hjunhuh/balancebot-course/part06_mech/README.md

# Part 6. 밸런싱로봇 기구 설계 with Fusion360

이 파트에서는 밸런싱 로봇의 몸체를 직접 설계합니다. 플레이트 3장(하판, 중판, 상판)과 모터 브래킷 1종을 Autodesk Fusion(옛 이름 Fusion 360)으로 모델링하고, 도면을 만들고, 조립해서 간섭을 확인한 뒤 STL로 내보내 3D 프린터로 출력합니다.

같은 부품을 Python 스크립트로도 만들 수 있게 준비했습니다. Fusion에서 만든 모델과 스크립트가 만든 STL을 비교하면 내 치수가 맞는지 바로 확인할 수 있고, 치수를 바꿔야 할 때 스크립트로 빠르게 다시 만들 수 있습니다.

이 파트에서 쓰는 기준 치수는 공통 사양서(SPEC.md) 5장을 그대로 따릅니다.

| 항목 | 값 |
|---|---|
| 플레이트 | 120 x 75 x 4 mm, 3장, 모서리 R4 |
| 모서리 홀 | M4 관통 Ø4.4, 가장자리에서 6 mm 안쪽 (홀 간격 108 x 63) |
| 층간 서포트 | M4 x 50 mm |
| 일반 M3 홀 | Ø3.4 |
| 모터 | 25 mm 기어드 DC 모터, 축 4 mm, 2개 |
| 바퀴 | 지름 130 mm |
| L298N 장착 홀 | 37 x 37 mm, M3 |
| Uno 장착 홀 (보드 기준) | (13.97, 2.54), (15.24, 50.80), (66.04, 7.62), (66.04, 35.56) |

결과물 폴더 구성은 다음과 같습니다.

| 경로 | 내용 |
|---|---|
| `part06_mech/cad/generate.py` | 파라메트릭 생성 스크립트 |
| `part06_mech/stl/` | plate_bottom, plate_middle, plate_top, motor_bracket STL |
| `part06_mech/dxf/` | 레이저 커팅용 플레이트 외곽선 DXF |
| `part06_mech/img/` | 2D 치수 도면과 조립 미리보기 그림 |

## 6-01 기구 설계가 제어에 미치는 영향

밸런싱 로봇은 바퀴 축을 받침점으로 하는 역진자(거꾸로 선 진자)입니다. 펌웨어(Part 8)에서 PID 게인을 아무리 잘 맞춰도 기구가 제어하기 어려운 모양이면 서 있지 못합니다. 설계를 시작하기 전에 네 가지 요소가 제어에 어떤 영향을 주는지 정리합니다.

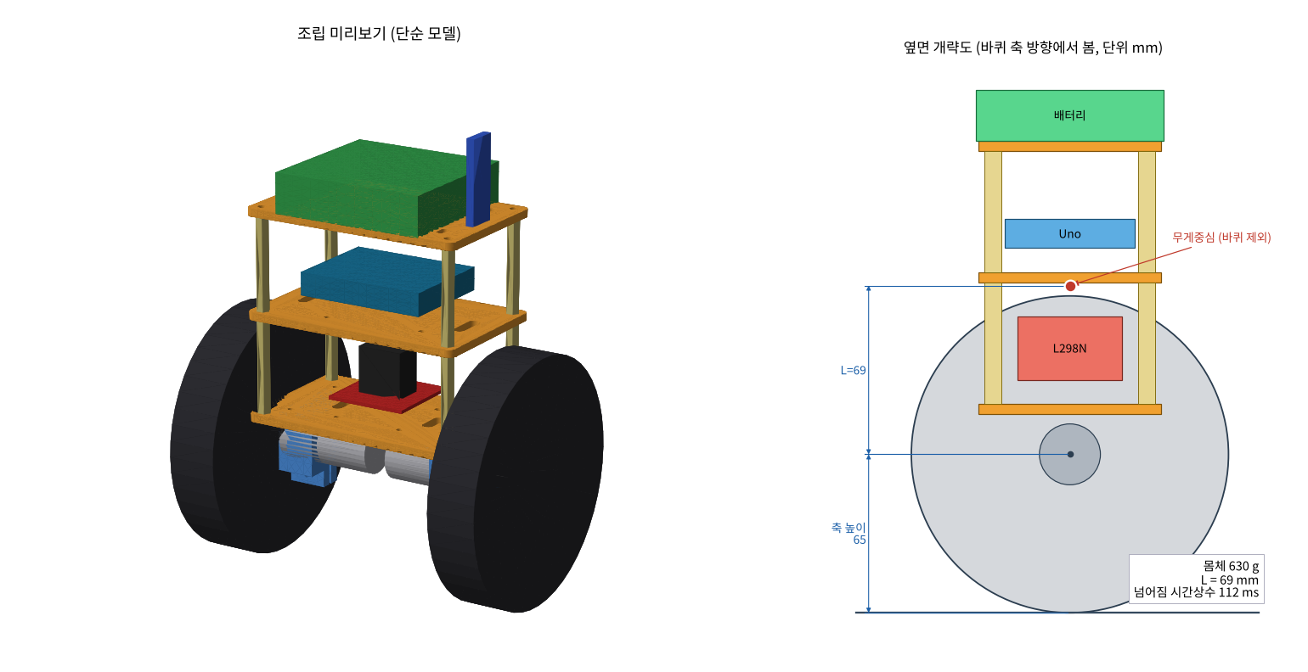
[picture p1: part06_mech/img/assembly_preview.png]
조립 미리보기와 무게중심


### 무게중심 높이 L

축에서 무게중심까지 거리를 L이라고 하면, 기울기 θ가 작을 때 몸체의 운동 방정식은 다음과 같습니다.

```
I * θ'' = m * g * L * θ      (I: 축 기준 관성 모멘트, m: 몸체 질량)
θ(t) = θ0 * e^(t / τ),       τ = sqrt( I / (m * g * L) )
```

τ(타우)는 넘어지는 속도를 나타내는 시간 상수입니다. 기울기가 τ마다 약 2.7배씩 커집니다. 질량이 한 점에 모여 있다고 보면 I = m L² 이므로 τ = sqrt(L / g) 가 되어, **무게중심이 높을수록 τ가 커지고 천천히 넘어집니다**. 빗자루를 손바닥에 세울 때 긴 빗자루가 더 쉬운 것과 같은 원리입니다.

생성 스크립트는 부품 질량 추정값으로 이 값을 직접 계산합니다.

| 배치 | 몸체 질량 | L | τ | 1도에서 20도까지 넘어지는 시간 (약 3τ) |
|---|---|---|---|---|
| 배터리를 상판에 둠 (이 과정의 설계) | 630 g | 69.3 mm | 112 ms | 약 336 ms |
| 배터리를 하판에 둔다고 가정 | 630 g | 32.7 mm | 85 ms | 약 255 ms |

제어 주기가 5 ms(SPEC 3장)이므로 τ = 112 ms 동안 제어기는 22번 모터 출력을 고칠 수 있습니다. 배터리 4개(약 210 g)를 상판에 올린 이유가 이것입니다. 다만 너무 높이면 같은 각도를 되돌리는 데 필요한 바퀴 이동 거리가 길어지고 몸체가 커져 다루기 불편하므로, 이 과정은 층간 50 mm 서포트로 적당한 높이를 정했습니다.

### 관성 모멘트 I

같은 질량과 같은 L이라도 질량이 위아래로 넓게 퍼져 있으면 I가 커져 τ가 조금 더 커집니다. 반대로 앞뒤(Y 방향)로 무거운 부품이 치우치면 무게중심이 축 바로 위에 오지 않습니다. 이 설계는 모든 부품을 플레이트 중심선(Y = 37.5 mm)에 맞춰 배치했습니다.

### 바퀴 지름

바퀴 지름 D와 모터 회전수 n(rpm)으로 바퀴 속도는 v = π D n / 60 입니다. 130 mm 바퀴는 한 바퀴에 약 408 mm를 갑니다. 지름이 크면 같은 모터로 더 빨리 몸체 밑으로 바퀴를 보낼 수 있지만, 바닥을 미는 힘은 F = 토크 / 반지름 이므로 줄어듭니다.

필요한 토크를 대략 계산해 봅니다. 기울기 5도를 되돌리려면 바퀴가 약 a = g tan(5도) = 0.86 m/s² 로 가속해야 합니다. 바퀴를 포함한 전체 질량을 0.73 kg 으로 보면 모터 한 개가 내야 하는 토크는 0.73 x 0.86 x 0.065 / 2 = 약 0.020 Nm (약 0.2 kgf cm) 입니다. 25 mm 기어드 모터는 감속비에 따라 정격 토크가 0.5 kgf cm 이상이므로 여유가 있습니다.

바퀴 지름은 축 높이(지면에서 65 mm)도 정합니다. 바퀴가 크면 몸체 전체가 올라가고, 넘어졌을 때 몸체가 바닥에 닿기 전 바퀴가 버텨 주는 범위도 넓어집니다. 스크립트 검사 결과 이 설계는 몸체를 100도 넘게 기울여야 바퀴 말고 다른 곳이 바닥에 닿습니다.

### 축 위치

바퀴 축은 무게중심의 바로 아래(앞뒤 방향 가운데)에 있어야 합니다. 무게중심이 축에서 앞뒤로 d 만큼 어긋나면 로봇이 서 있는 각도가 atan(d / L) 만큼 기웁니다. 예를 들어 d = 3 mm, L = 69 mm 이면 약 2.5도입니다. 이 차이는 블루투스 명령 `$T` (기준 각도 보정, SPEC 4장)로 보정할 수 있지만, 처음부터 대칭으로 만드는 것이 좋습니다. 또한 모터 축은 하판 아랫면에서 16.6 mm 아래에 두어, 무거운 모터(2개 약 190 g)가 축 근처에 모이게 했습니다.

## 6-02 Fusion360 설치(개인용 무료 라이선스)와 화면 구성, 단위 mm 설정

### 설치와 개인용 라이선스

Autodesk Fusion은 수익이 거의 없는 개인 취미 용도라면 "Fusion for personal use" 라이선스로 무료로 쓸 수 있습니다.

1. Autodesk 웹사이트에서 "Fusion for personal use" 페이지로 갑니다.
2. Autodesk 계정을 만들고 개인용 라이선스 조건(비상업, 프로젝트 수익 연 1,000 달러 미만)에 동의합니다.
3. 설치 프로그램(Windows, macOS)을 내려받아 실행하고 같은 계정으로 로그인합니다.

개인용 라이선스에는 제한이 있고 Autodesk가 조건을 바꾸기도 하므로 설치할 때 공식 페이지를 다시 확인합니다. 이 과정과 관련된 제한은 다음과 같습니다 (작성 시점 기준).

| 제한 | 이 과정에서의 대응 |
|---|---|
| 편집 가능한 활성 문서 10개 | 로봇 전체를 문서 1개 안의 컴포넌트 여러 개로 만듭니다 (부품마다 문서를 따로 만들지 않습니다) |
| 내보내기 형식 제한 (STL, STEP, 3MF 등은 가능) | STL은 Fusion에서 내보내고, 레이저 커팅용 DXF는 생성 스크립트가 만든 `part06_mech/dxf/` 를 씁니다 |
| 도면(Drawing)은 시트 1장, 내보내기 제한 | 부품마다 시트 1장으로 만들고 인쇄 기능으로 출력합니다 |
| 라이선스 기간 | 기간이 끝나면 계정 페이지에서 갱신합니다 |

### 화면 구성

처음 실행해서 새 디자인을 열면 다음 영역이 보입니다.

| 영역 | 위치 | 역할 |
|---|---|---|
| 데이터 패널 | 왼쪽 위 격자 아이콘 | 클라우드에 저장된 프로젝트와 문서 목록 |
| 툴바 | 위쪽 | 작업공간(DESIGN, DRAWING 등) 선택과 탭(SOLID, SURFACE, MESH 등), 명령 버튼 |
| 브라우저 | 왼쪽 | 원점(Origin), 컴포넌트, 바디, 스케치 트리. 눈 아이콘으로 보이기와 숨기기 |
| 캔버스 | 가운데 | 모델이 보이는 3D 화면 |
| 뷰 큐브 | 오른쪽 위 | 클릭해서 정면, 윗면, 등각 보기로 전환 |
| 타임라인 | 아래쪽 | 지금까지 한 작업 기록. 항목을 더블클릭하면 그 단계를 다시 편집 |
| 내비게이션 바 | 아래 가운데 | 회전(Orbit), 이동(Pan), 확대, 화면 맞춤 |

마우스 조작: 휠 드래그로 이동, Shift + 휠 드래그로 회전, 휠 굴리기로 확대와 축소입니다. 명령 이름을 모를 때는 `S` 키를 눌러 검색창에 이름(예 Extrude)을 입력합니다.

### 단위 mm와 Z 위쪽 설정

1. 오른쪽 위 계정 이름을 눌러 Preferences 를 엽니다.
2. General > Design 에서 Default modeling orientation 을 **Z up** 으로 바꿉니다. 이 과정의 좌표(X 길이, Y 폭, Z 높이)와 생성 스크립트가 이 방향을 씁니다.
3. Unit and Value Display (또는 Default Units > Design) 에서 Default units 를 **Millimeter** 로 바꿉니다.
4. 이미 열려 있는 문서는 브라우저 맨 위 문서 이름 아래 Document Settings > Units 의 연필 아이콘을 눌러 Millimeter 로 바꿉니다.
5. 데이터 패널에서 New Project 로 `balancebot` 프로젝트를 만들고, 새 디자인을 `balancebot_mech` 이름으로 저장합니다(Ctrl + S).

이 파트에서 만들 결과물

## 6-03 스케치 기본 (선, 사각형, 원, 구속조건, 치수 구속, 완전 구속 확인)

3D 모델은 대부분 2D 스케치에서 시작합니다. 스케치를 정확히 "구속"하는 습관이 기구 설계의 기본입니다.

### 스케치 만들기

1. SOLID 탭 > CREATE > Create Sketch 를 누릅니다.
2. 캔버스에 나타난 세 평면 중 XY 평면(바닥에 누운 평면)을 클릭합니다.
3. 툴바가 SKETCH 탭으로 바뀝니다. 끝낼 때는 오른쪽 위 Finish Sketch 를 누릅니다.

### 기본 도형

| 도구 | 단축키 | 사용법 |
|---|---|---|
| Line | L | 클릭, 클릭으로 선분. 클릭 후 드래그하면 접하는 호 |
| 2-Point Rectangle | R | 대각선 두 점. 클릭 후 숫자 입력, Tab 으로 다음 칸 |
| Center Rectangle | | 중심과 한 꼭짓점 |
| Center Diameter Circle | C | 중심 클릭 후 지름 입력 |
| Center to Center Slot | | 두 중심점과 폭으로 긴 구멍 |
| Point | | 구멍 위치 표시용 점 |
| Construction (토글) | X | 선택한 선을 보조선(점선)으로 바꿈. 보조선은 형상을 만들지 않음 |

### 구속조건 (Constraints)

구속조건은 도형 사이의 관계를 고정합니다. SKETCH 탭 오른쪽 CONSTRAINTS 그룹에 있습니다.

| 구속 | 의미 | 이 과정에서 쓰는 곳 |
|---|---|---|
| Horizontal / Vertical | 수평, 수직 | 사각형 변 (자동으로 붙음) |
| Coincident | 점을 점이나 선 위에 붙임 | 사각형 꼭짓점을 원점에 |
| Concentric | 두 원의 중심 일치 | 홀과 서포트 |
| Midpoint | 점을 선의 중점에 | 플레이트 중심선 |
| Equal | 길이나 지름이 같게 | 같은 지름 홀 여러 개 |
| Symmetry | 선을 기준으로 대칭 | 좌우 슬롯, 브래킷 단면 |
| Fix | 위치를 고정 | 가능하면 쓰지 않고 치수로 고정 |

### 치수 구속 (Sketch Dimension, D)

`D` 를 누르고 선이나 두 점, 원을 차례로 클릭한 뒤 놓을 곳을 클릭하고 값을 입력합니다. 원을 클릭하면 지름 치수, 두 점을 클릭하면 거리 치수가 됩니다. 치수 값에 `plate_l / 2` 같은 식도 쓸 수 있습니다 (MODIFY > Change Parameters 에서 사용자 파라미터를 만들면 생성 스크립트처럼 이름으로 치수를 관리할 수 있습니다).

### 완전 구속 확인

- 아직 움직일 수 있는 선은 **파란색**, 완전히 고정된 선은 **검은색** 으로 보입니다.
- 브라우저의 스케치 아이콘에 자물쇠가 표시되면 그 스케치 전체가 완전 구속입니다.
- 파란 선을 마우스로 끌어 보면 어느 방향으로 자유도가 남았는지 알 수 있습니다.

완전 구속이 안 된 스케치는 나중에 다른 치수를 고칠 때 엉뚱하게 움직입니다. 각 스케치를 끝내기 전에 모든 선이 검은색인지 확인하는 습관을 들입니다.

연습: 아래 하판 도면의 외곽(120 x 75)과 모서리 홀 A1 (6, 6) 하나를 스케치하고 완전 구속해 봅니다. 사각형 한 꼭짓점을 원점에 Coincident, 가로 120, 세로 75, 원 지름 4.4, 원 중심에서 왼쪽 변까지 6, 아래 변까지 6 을 주면 모두 검은색이 됩니다.

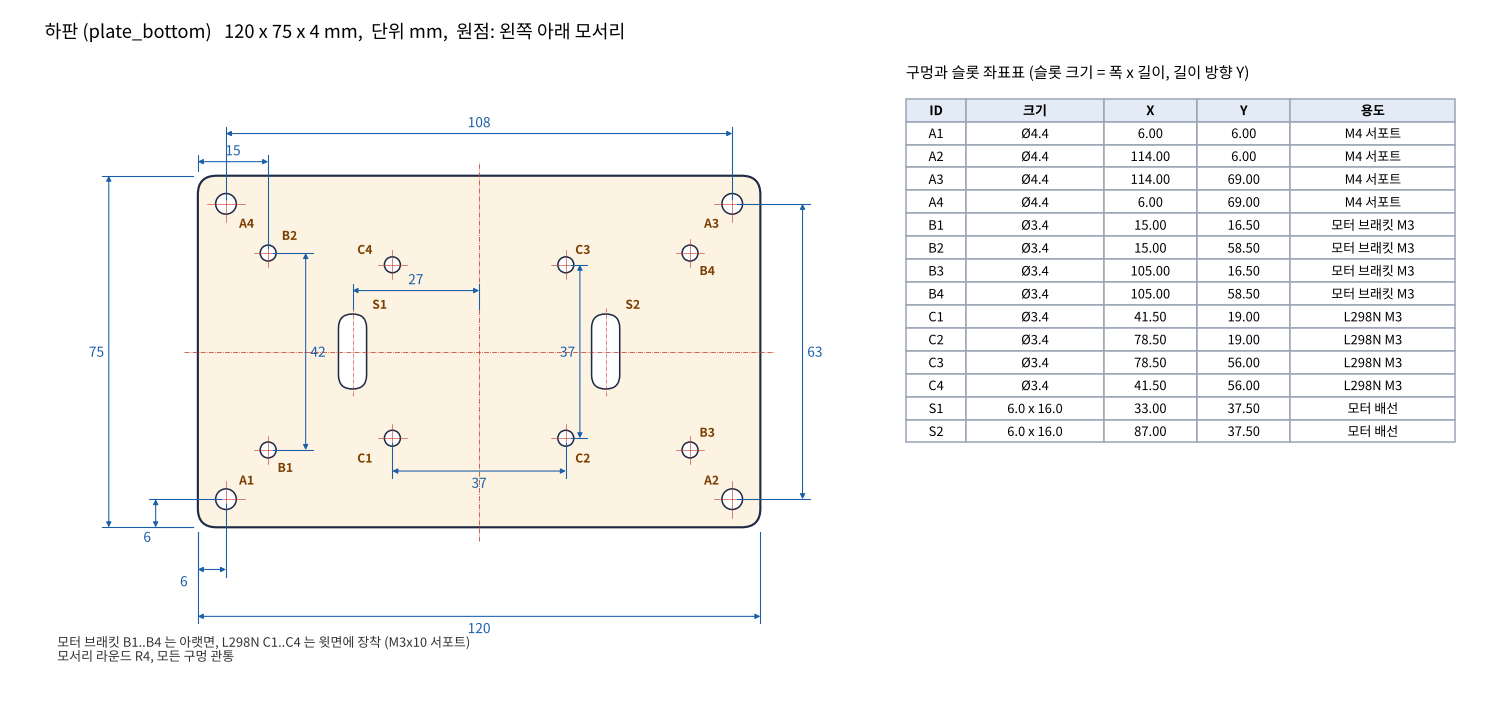
[picture p2: part06_mech/img/drawing_bottom.png]
하판 도면


## 6-04 Extrude, Hole, Fillet, Chamfer, Mirror, Pattern

이 과정의 부품은 여섯 가지 명령으로 거의 다 만들 수 있습니다.

| 명령 | 위치 (SOLID 탭) | 단축키 | 핵심 옵션 |
|---|---|---|---|
| Extrude | CREATE | E | Profile(닫힌 영역) 선택, Distance, Operation (New Body, Join, Cut, New Component) |
| Hole | CREATE | H | 위치(면 위 클릭 또는 스케치 점), Extents = All, Hole Type = Simple, Diameter |
| Fillet | MODIFY | F | 모서리 선택, Radius |
| Chamfer | MODIFY | | 모서리 선택, Distance |
| Mirror | CREATE | | Pattern Type (Faces, Features, Bodies), Mirror Plane |
| Rectangular Pattern | CREATE > Pattern | | 대상, 방향 2개, Quantity, Distance, Distribution (Spacing 은 간격, Extent 는 전체 길이) |
| Circular Pattern | CREATE > Pattern | | 대상, 축, Quantity |

알아 둘 점:

- **Extrude Cut 과 Hole 의 차이**: 원을 스케치해 Extrude Cut 해도 구멍이 생기지만, Hole 명령으로 만들면 도면에서 구멍 주석(지름, 관통)이 자동으로 붙고 나중에 볼트 규격으로 바꾸기 쉽습니다. 원형 관통홀은 Hole, 슬롯은 Extrude Cut 을 씁니다.
- **Extent = All**: 판 두께를 바꿔도 구멍이 끝까지 뚫리도록 깊이 대신 All(관통)을 고릅니다.
- **Pattern 대상 선택**: Features 로 패턴하면 원본 피처를 고쳤을 때 복사본도 같이 바뀝니다.
- **Mirror 평면**: 플레이트 중심을 지나는 평면이 필요하면 CONSTRUCT > Midplane 으로 양 끝면 사이 중간 평면을 만듭니다.
- **Fillet 과 Chamfer**: 플레이트 모서리 R4 는 Fillet 으로, 모터 구멍 입구처럼 끼워 넣는 곳은 Chamfer 0.5 mm 로 입구를 넓히면 조립이 쉽습니다.

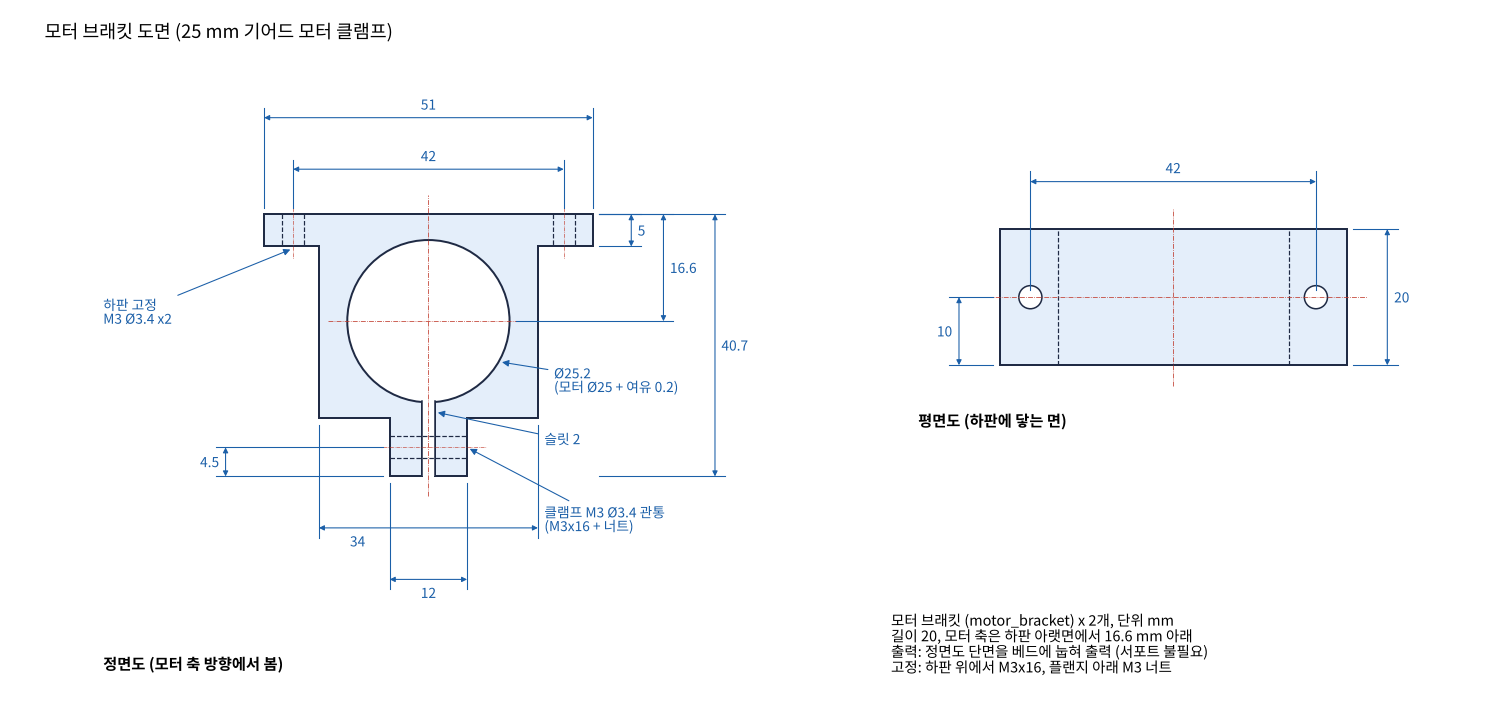
[picture p3: part06_mech/img/drawing_bracket.png]
모터 브래킷 도면


## 6-05 하판 모델링 따라하기 (단계별 클릭 순서와 수치)

하판은 모터 브래킷 2개(아랫면)와 L298N(윗면)을 받칩니다. 아래 도면의 좌표표를 옆에 띄워 두고 따라 합니다. 좌표 원점은 플레이트 왼쪽 아래 모서리입니다.

하판 도면

### 1단계: 컴포넌트 만들기

1. 브라우저 맨 위 문서 이름을 오른쪽 클릭 > New Component.
2. Name 에 `plate_bottom` 입력, OK.
3. 브라우저에서 `plate_bottom` 옆 라디오 버튼이 켜져 있는지(활성 컴포넌트) 확인합니다. 이후 만드는 스케치와 바디는 이 컴포넌트 안에 들어갑니다.

### 2단계: 외곽과 Extrude

1. Create Sketch > XY 평면.
2. 2-Point Rectangle(R): 원점 클릭, `120` 입력, Tab, `75` 입력, Enter.
3. 모든 선이 검은색인지 확인 (원점에 붙었으므로 완전 구속). Finish Sketch.
4. Extrude(E): 사각형 안쪽 클릭, Distance `4`, Operation New Body, OK.
5. Fillet(F): 판의 세로 모서리 4개(두께 방향 짧은 모서리)를 클릭, Radius `4`, OK.

### 3단계: 모서리 M4 홀 4개

1. Hole(H): 판 윗면을 클릭해 위치를 정합니다. 나타난 기준 핸들로 왼쪽 변과 아래 변을 차례로 클릭하고 각각 `6` 입력.
2. Extents `All`, Hole Type `Simple`, Diameter `4.4`, OK.
3. Rectangular Pattern: Pattern Type `Features`, Objects 에서 타임라인의 방금 만든 Hole 을 선택.
4. Directions 에서 판의 아래 긴 모서리 선택, Distribution `Spacing`, Quantity `2`, Distance `108`.
5. 두 번째 방향(Direction 2)으로 왼쪽 짧은 모서리 선택, Quantity `2`, Distance `63`. 화살표 방향이 판 안쪽을 향하는지 확인하고 OK.

### 4단계: 모터 브래킷 고정 M3 홀 4개 (B1 ~ B4)

1. 판 윗면에 Create Sketch.
2. Point 로 점 2개를 찍고 치수(D)로 B1 (15, 16.5), B2 (15, 58.5) 를 맞춥니다. 왼쪽 변에서 `15`, 아래 변에서 `16.5` 와 `58.5`.
3. Finish Sketch, Hole(H) 에서 Sketch Points 로 두 점을 고르고 Extents `All`, Diameter `3.4`.
4. Mirror: Pattern Type `Features`, 방금 Hole 선택, Mirror Plane 은 CONSTRUCT > Midplane 으로 왼쪽 끝면과 오른쪽 끝면 사이에 만든 평면(X = 60). B3 (105, 16.5), B4 (105, 58.5) 가 생깁니다.

간격 42 mm 는 브래킷 플랜지의 고정 홀 간격과 같아야 합니다. 브래킷 위치(X = 15)는 모터 기어박스 앞면이 플레이트 가장자리에서 2 mm 안쪽, 브래킷이 그 앞면에서 3 mm 떨어진 위치에서 계산된 값입니다 (브래킷 길이 20 mm 의 중심 = 2 + 3 + 10).

### 5단계: L298N M3 홀 4개 (C1 ~ C4)

1. Hole(H): 윗면을 클릭하고 기준 모서리에서 X `41.5`, Y `19` 를 입력, Diameter `3.4`, Extents `All`.
2. Rectangular Pattern: 방금 Hole, 방향 1 은 긴 모서리 Quantity `2` Distance `37`, 방향 2 는 짧은 모서리 Quantity `2` Distance `37`.
3. 결과 C1 (41.5, 19), C2 (78.5, 19), C3 (78.5, 56), C4 (41.5, 56). 37 x 37 정사각형의 중심이 판 중심 (60, 37.5) 과 같은지 확인합니다.

### 6단계: 모터 배선 슬롯 (S1, S2)

1. 판 윗면에 Create Sketch.
2. Center to Center Slot: 첫 중심 (33, 32.5), 둘째 중심 (33, 42.5), 폭 `6`. 결과 슬롯은 6 x 16 mm 입니다 (중심 간 거리 10 + 양 끝 반원 3 + 3).
3. 위 중심을 수평 중심선(Y = 37.5)에 대해 Symmetry 로 묶고, 왼쪽 변에서 `33` 치수를 주어 완전 구속합니다.
4. Finish Sketch, Extrude(E): 슬롯 안쪽 선택, Operation `Cut`, Extent `All`.
5. Mirror 로 S2 (87, 37.5) 를 만듭니다.

### 7단계: 확인

브라우저에서 바디를 오른쪽 클릭 > Properties 를 열어 Volume 이 약 **34,705 mm³ (34.7 cm³)** 인지 봅니다. 생성 스크립트가 계산한 이론 부피와 같으면 구멍 크기와 개수가 모두 맞은 것입니다.

## 6-06 중판

중판에는 Arduino Uno(쉴드 포함)를 M3 x 10 서포트로 띄워 장착합니다.

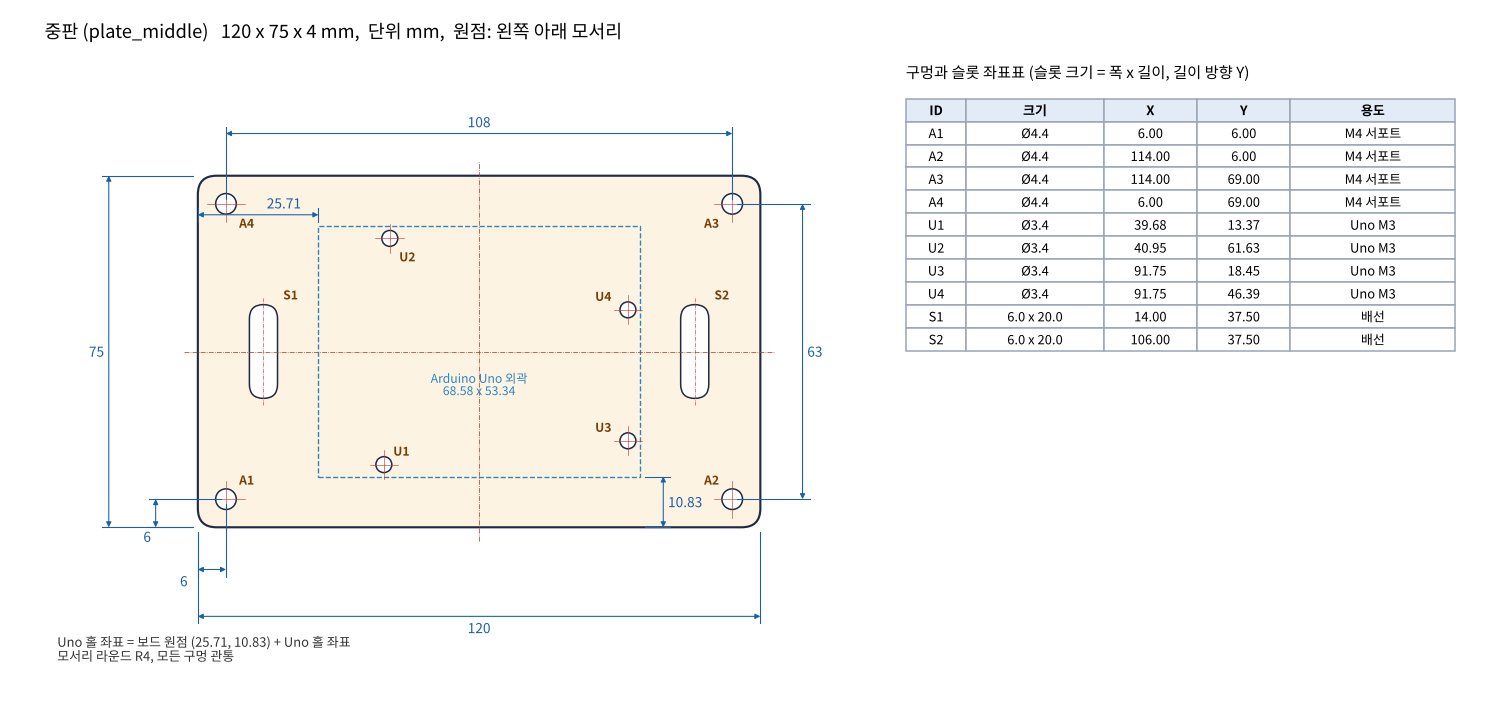
[picture p4: part06_mech/img/drawing_middle.png]
중판 도면


1. New Component `plate_middle`, 하판 2단계와 3단계를 그대로 반복합니다 (외곽 120 x 75 x 4, R4, 모서리 M4 홀 4개). 하판을 복사해서 구멍을 지우는 것보다 처음부터 만드는 편이 타임라인이 깔끔합니다.
2. 판 윗면에 Create Sketch, Center Rectangle 로 Uno 외곽 `68.58` x `53.34` 를 그리고 X(Construction) 로 보조선으로 바꿉니다.
3. 보조 사각형의 중심점을 판 중심에 맞춥니다. 판 윗면 모서리의 중점들을 잇는 보조선 2개를 그리고 그 교점에 Coincident. 이렇게 하면 Uno 원점(보드 왼쪽 아래)은 (25.71, 10.83) 이 됩니다.
4. Point 4개를 찍고 보조 사각형의 왼쪽 아래 꼭짓점 기준으로 치수를 줍니다.

| 홀 | 보드 기준 | 플레이트 기준 |
|---|---|---|
| U1 | (13.97, 2.54) | (39.68, 13.37) |
| U2 | (15.24, 50.80) | (40.95, 61.63) |
| U3 | (66.04, 7.62) | (91.75, 18.45) |
| U4 | (66.04, 35.56) | (91.75, 46.39) |

5. Hole(H): Sketch Points 로 4점 선택, Diameter `3.4`, Extents `All`.
6. 배선 슬롯 S1: Center to Center Slot, 중심 (14, 30.5) 과 (14, 44.5), 폭 `6` (결과 6 x 20). Extrude Cut All. Mirror 로 S2 (106, 37.5).
7. Properties 의 Volume 이 약 **34,658 mm³** 인지 확인합니다.

Uno 의 USB 단자와 전원 잭은 보드 왼쪽(X 가 작은 쪽)에 있습니다. 보드 방향을 도면과 같게 놓으면 USB 단자가 S1 슬롯 쪽을 향하므로 케이블을 연결할 수 있습니다. U2 홀은 USB 단자 옆이라 볼트 머리가 단자에 닿을 수 있으니 나일론 볼트나 작은 머리 볼트를 씁니다.

## 6-07 상판

상판에는 18650 4구 홀더를 케이블타이로 묶고, HC-05 를 핀헤더가 아래로 향하게 세워 꽂습니다.

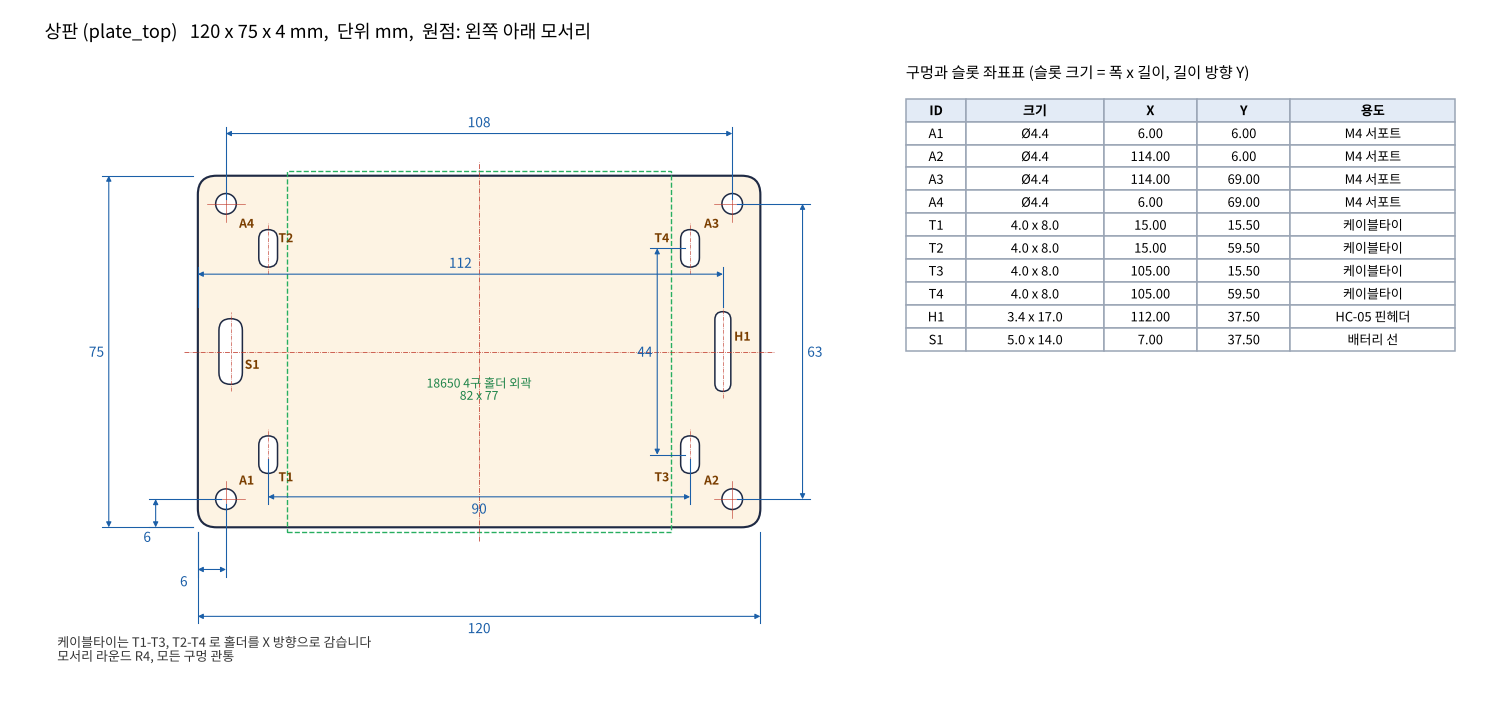
[picture p5: part06_mech/img/drawing_top.png]
상판 도면


1. New Component `plate_top`, 외곽과 모서리 M4 홀은 하판과 같습니다.
2. 케이블타이 슬롯 T1 ~ T4 (4 x 8 mm, 길이 방향 Y):
   1. Center to Center Slot, 중심 (15, 13.5) 과 (15, 17.5), 폭 `4`. 결과 T1 중심 (15, 15.5).
   2. Extrude Cut All.
   3. Rectangular Pattern: 방향 1 긴 모서리 Quantity `2` Distance `90`, 방향 2 짧은 모서리 Quantity `2` Distance `44`.
3. HC-05 슬롯 H1: 중심 (112, 30.7) 과 (112, 44.3), 폭 `3.4` 인 슬롯(3.4 x 17), Extrude Cut All. 6핀 헤더(길이 15.24 mm)가 들어갑니다.
4. 배터리 선 슬롯 S1: 중심 (7, 33) 과 (7, 42), 폭 `5` (5 x 14), Extrude Cut All.
5. Properties 의 Volume 이 약 **34,765 mm³** 인지 확인합니다.

배터리 홀더는 82 x 77 mm 로 가정했습니다. Y 방향 77 mm 가 플레이트 폭 75 mm 보다 커서 앞뒤로 1 mm 씩 나오지만 서포트(모서리)와는 9 mm 떨어져 있어 문제없습니다. 케이블타이(폭 3.6 mm 이하, 길이 300 mm) 2개를 T1 에서 T3 로, T2 에서 T4 로 홀더 위를 X 방향으로 감아 묶습니다. 홀더 크기가 다르면 생성 스크립트의 `BATT_HOLDER` 를 바꿔 슬롯 위치를 다시 계산합니다.

## 6-08 모터 브래킷

25 mm 원형 기어드 모터를 감싸 쥐는 클램프 블록입니다. 위쪽 플랜지를 하판 아랫면에 M3 볼트 2개로 고정하고, 아래쪽 귀(ear)를 M3 볼트로 조여 모터를 잡습니다. 같은 부품 2개를 좌우에 씁니다.

모터 브래킷 도면

| 치수 | 값 | 이유 |
|---|---|---|
| 모터 구멍 | Ø25.2 | 모터 Ø25 + 여유 0.2. 슬릿을 조여 잡음 |
| 플랜지 | 51 x 5 | 고정 홀 간격 42 와 너트 자리 |
| 몸통 폭 | 34 | 구멍 양옆 벽 4.4 |
| 윗면에서 축까지 | 16.6 | 위 벽 4 + 반지름 12.6 |
| 전체 높이 | 40.7 | 아래 벽 2.5, 귀 높이 9 |
| 슬릿 | 2 | 조이면 구멍이 줄어 모터를 잡음 |
| 클램프 홀 | Ø3.4, 바닥에서 4.5 | M3 x 16 + 너트 (귀 폭 12 + 너트 2.4 = 14.4) |
| 길이 | 20 | 모터 축 방향 |

따라하기:

1. New Component `motor_bracket`.
2. YZ 평면(모터 축 X 에 수직인 평면)에 Create Sketch. 한 번에 단면 전체를 그립니다.
   1. Line 으로 위 표의 외곽(플랜지, 몸통, 귀)을 한 붓 그리기로 그립니다. 플랜지 윗면을 원점 높이에 두고, 세로 보조선(Construction) 하나를 원점에서 아래로 그려 대칭 기준으로 씁니다.
   2. 좌우 대응 선분을 Symmetry 로 묶은 뒤 치수 51, 5, 34, 40.7, 12 를 줍니다.
   3. Center Diameter Circle 로 구멍 Ø25.2, 중심을 대칭 보조선 위, 윗면에서 16.6 아래에 둡니다.
   4. 슬릿: 대칭 보조선 양쪽 1 mm 에 세로선 2개를 원 아래쪽부터 바닥까지 그리고 바닥 선을 Trim(T) 으로 잘라 냅니다.
   5. 모든 선이 검은색인지 확인하고 Finish Sketch.
3. Extrude(E): 원과 슬릿을 뺀 단면 영역 선택, Direction `Symmetric`, Distance `20` (전체 20). 단면이 YZ 평면 양쪽으로 10 mm 씩 나옵니다.
4. 플랜지 고정 홀: Hole(H), 플랜지 윗면, 대칭선에서 좌우 `21`, 길이 방향 가운데(`10`), Diameter `3.4`, Extents `All`.
5. 클램프 홀: Hole(H), 귀의 옆면을 클릭, 바닥에서 `4.5`, 길이 방향 가운데, Diameter `3.4`, Extents `All` (귀 두 개와 슬릿을 모두 관통).
6. 선택: Chamfer 0.5 mm 를 모터 구멍 양쪽 입구에 줍니다.

플랜지 고정 너트(M3, 대변 5.5 mm)는 플랜지 아랫면에서 몸통 옆에 놓입니다. 너트 중심이 대칭선에서 21 mm, 몸통 옆면이 17 mm 이므로 너트와 몸통 사이는 0.82 mm 입니다. 생성 스크립트가 이 값을 검사하며, 모터 지름이나 고정 홀 간격을 바꿀 때 가장 먼저 걸리는 항목입니다.

## 6-09 배터리팩, DC 모터, 바퀴 단순 모델 (조립 확인용)

조립에서 간섭과 무게중심을 보려면 실제 부품 크기의 단순 모델이 필요합니다. 세부 모양은 필요 없고 바깥 크기만 맞으면 됩니다. 각각 컴포넌트로 만듭니다.

| 컴포넌트 | 만드는 법 | 치수 |
|---|---|---|
| `motor` | Circle Ø25 를 Extrude 52, 앞면 중심에 Circle Ø4 를 Extrude 12 (Join) | 몸통 Ø25 x 52, 축 Ø4 x 12 |
| `wheel` | Circle Ø130 을 Extrude 26, 중심에 Ø4 Hole | Ø130 x 26 |
| `battery_pack` | Rectangle 82 x 77 을 Extrude 21 | 82 x 77 x 21 |
| `support_m4` | Polygon(Inscribed, 6각) 대변 7 을 Extrude 50, 중심 Ø4 Hole | 육각 7 x 50 |
| `l298n` | 43 x 43 x 1.6 판 + 방열판 24 x 16 x 24 | |
| `uno` | 68.58 x 53.34 x 12 상자 | |

조립 미리보기

생성 스크립트의 미리보기 그림도 같은 방식으로 바퀴와 모터, 서포트를 원통으로 넣어 그렸습니다. 실제 모터 길이는 감속비마다 다르므로(약 50 ~ 65 mm) 가지고 있는 모터를 자로 재서 고칩니다. 바퀴와 배터리를 컴포넌트 Properties 의 Physical Material 이나 Override 질량으로 실제 무게를 넣으면 INSPECT > Center of Mass 로 무게중심을 바로 볼 수 있습니다.

## 6-10 2D 도면 작성 (Drawing 워크스페이스)

도면은 출력 대행을 맡기거나 레이저 커팅을 의뢰할 때, 그리고 조립할 때 옆에 두고 보는 자료입니다.

1. 하판 컴포넌트만 보이게 하고 File > New Drawing > From Design 을 누릅니다.
2. 대화상자에서 Full Assembly 대신 `plate_bottom` 만 선택, Standard `ISO`, Units `mm`, Sheet Size `A4`, OK.
3. Base View 가 마우스에 붙어 나옵니다. Orientation `Top`, Scale `1:1`, Style 은 숨은선 없는 것으로 정하고 시트 왼쪽에 클릭해 놓습니다.
4. Projected View: 기준도를 클릭하고 아래로 끌어 정면도(두께 4 mm 확인용)를 놓습니다.
5. Center Mark Pattern 으로 모든 구멍에 중심선을 넣습니다.
6. Dimension(D): 전체 120 과 75, 모서리 홀 간격 108 과 63, 가장자리에서 6 을 넣습니다. 치수끼리 겹치면 드래그해 바깥으로 뺍니다.
7. 구멍이 많으면 TABLES > Hole Table 로 원점을 판 왼쪽 아래 모서리로 정해 좌표표를 만듭니다. 아래 그림의 오른쪽 표와 같은 형태입니다.
8. Text 로 재료(PLA), 수량, 두께를 표제란에 적습니다.
9. 출력은 Print 로 합니다 (개인용 라이선스는 도면 내보내기가 제한될 수 있습니다).

생성 스크립트도 같은 정보를 담은 도면 그림을 만듭니다. 내 Fusion 도면과 비교해 숫자가 같은지 확인합니다.

하판 도면
중판 도면
상판 도면
모터 브래킷 도면

도면 읽는 법: 빨간 1점 쇄선은 중심선, 파란 선은 치수선, 점선은 숨은선(보이지 않는 구멍)입니다. 중판과 상판의 파란 또는 초록 점선 사각형은 Uno 와 배터리 홀더 외곽으로, 실제로 가공하는 선이 아니라 배치 확인용입니다.

## 6-11 어셈블리와 Joint (Rigid, Revolute), 간섭 검사(Interference)

### 위치 관계

지면을 Z = 0 으로 하면 각 부품의 높이는 다음과 같습니다 (스크립트가 계산한 값).

| 항목 | Z (mm) | 계산 |
|---|---|---|
| 바퀴 축 | 65.0 | 바퀴 지름 130 / 2 |
| 하판 아랫면 | 81.6 | 축 + 16.6 (브래킷 윗면에서 축까지) |
| 중판 아랫면 | 135.6 | 하판 + 두께 4 + 서포트 50 |
| 상판 아랫면 | 189.6 | 중판 + 4 + 50 |
| 브래킷 바닥 (최저점) | 40.9 | 지면 여유 |

### Joint 걸기

Fusion 에서 컴포넌트를 움직이지 않게 기준을 하나 정하고, 나머지는 Joint 로 붙입니다.

1. 브라우저에서 `plate_bottom` 오른쪽 클릭 > Ground. 이 부품은 고정됩니다.
2. ASSEMBLE > Joint(J). Component 1 에서 브래킷 플랜지 고정 홀의 윗면 원 중심을, Component 2 에서 하판 B1 홀 아랫면 원 중심을 클릭합니다. Motion Type `Rigid`, OK. 회전이 어긋나면 Joint 대화상자의 Angle 에 90 을 넣습니다.
3. 오른쪽 브래킷도 B3 홀에 같은 방법으로 Rigid.
4. 모터: 기어박스 앞면 원 중심과 브래킷 구멍 원 중심을 고르고 Offset 으로 앞면이 판 가장자리에서 2 mm 안쪽에 오게 맞춥니다. Rigid.
5. 바퀴: 바퀴 허브 안쪽 면 원 중심과 모터 축 끝 원 중심을 고르고 Motion Type `Revolute`. 회전축이 X 인지 확인합니다. OK 후 바퀴를 마우스로 끌면 축을 중심으로 돌아갑니다. Joint 를 오른쪽 클릭 > Animate Joint 로도 확인할 수 있습니다.
6. 서포트와 중판, 상판, 전장품은 모두 Rigid 입니다. 이미 제자리에 놓인 부품은 As-built Joint(Shift + J) 로 현재 위치 그대로 붙이면 빠릅니다.

Rigid 는 자유도 0 (완전히 붙음), Revolute 는 축 하나를 중심으로 회전 1 자유도입니다. 그 밖에 Slider(직선 이동), Cylindrical(회전 + 이동), Ball(구면) 이 있지만 이 로봇에는 필요 없습니다.

### 간섭 검사

1. INSPECT > Interference.
2. Objects 에 모든 컴포넌트를 선택(캔버스에서 드래그 선택), Compute.
3. 결과 표에 간섭 쌍이 나오고, 겹치는 부피가 빨간색으로 보입니다.

이 설계는 간섭이 0 이 나와야 합니다. 자주 나오는 경우와 해결은 다음과 같습니다.

| 결과 | 원인 | 해결 |
|---|---|---|
| motor 와 motor_bracket | 모터 구멍을 Ø25 로 그림 | 구멍 Ø25.2 로 수정 |
| wheel 과 plate_bottom | 바퀴가 판 쪽으로 들어옴 | 바퀴를 축 끝 쪽으로, 판과 3 mm 이상 띄움 |
| motor 와 motor (좌우) | 모터가 길어 가운데서 만남 | 모터 길이 확인. 이 설계는 뒷면 사이 12 mm |
| l298n 과 plate_middle | 방열판이 높음 | 방열판 윗면은 중판 아래 14 mm, 서포트 길이 확인 |

생성 스크립트는 같은 내용을 수치로 검사합니다. 특히 바퀴는 플레이트 좌우 바깥(X 가 0 보다 작은 쪽과 120 보다 큰 쪽)에 있어야 하므로, 바퀴의 X 구간 [-29, -3] 이 플레이트 [0, 120] 와 겹치지 않는지와 간격이 2 mm 이상인지 확인합니다. 바퀴 지름 130 mm 는 Y 방향으로 플레이트 폭 75 mm 보다 크지만, 바퀴가 X 방향 바깥에 있으므로 간섭이 아닙니다.

조립 미리보기

## 6-12 STL 내보내기와 3D 프린팅

### STL 내보내기

1. 브라우저에서 바디(컴포넌트 안의 Bodies > Body1) 를 오른쪽 클릭 > Save As Mesh (버전에 따라 Export 또는 3D Print).
2. Format `STL (Binary)`, Unit Type `Millimeter`, Refinement `High`.
3. 파일 이름은 `plate_bottom.stl` 처럼 컴포넌트 이름과 같게 저장합니다.
4. 단순 모델(모터, 바퀴, 배터리)은 내보내지 않습니다.

내보낸 STL 을 슬라이서에서 열었을 때 크기가 120 x 75 x 4 가 아니고 25.4 배 작거나 크면 단위를 잘못 고른 것입니다.

### 출력 설정 (FDM, 노즐 0.4 mm 기준)

| 항목 | 값 |
|---|---|
| 재료 | PLA |
| 레이어 높이 | 0.2 mm |
| 인필 | 30 % (Grid 또는 Gyroid) |
| 벽 (Wall line count, Perimeters) | 3 |
| 위, 아래 면 레이어 | 4 |
| 노즐, 베드 온도 | 200 ~ 210 도, 60 도 (필라멘트 권장값 우선) |
| 서포트 | 필요 없음 |
| 바닥 접착 | 스커트. 판이 휘면 브림 5 mm |

부품별 출력 방향:

| 부품 | 수량 | 놓는 방향 | 서포트 |
|---|---|---|---|
| plate_bottom, plate_middle, plate_top | 각 1 | 판을 베드에 눕혀서 | 없음. 모든 구멍이 수직 |
| motor_bracket | 2 | 정면도 단면이 베드에 닿게 세워서 (모터 구멍이 위를 향함) | 없음. 가로 방향 M3 홀은 3.4 mm 로 작아 브리지로 출력됨 |

제공 STL 의 motor_bracket 은 이미 이 방향(모터 구멍 축이 Z)으로 저장되어 있습니다. 이렇게 세우면 클램프 슬릿을 조일 때 힘이 레이어를 따라 걸려 잘 깨지지 않습니다. 반대로 플랜지를 베드에 두면 모터 구멍 윗부분이 허공에 떠서 서포트가 필요하고 구멍이 거칠어집니다.

FDM 프린터는 구멍이 0.1 ~ 0.3 mm 작게 나오는 경향이 있습니다. 슬라이서의 구멍 보정(Cura 의 Hole Horizontal Expansion, PrusaSlicer 와 OrcaSlicer 의 X-Y hole compensation) 을 0.1 ~ 0.15 mm 로 주거나, 출력 후 3.5 mm, 4.5 mm 드릴로 한 번 다듬습니다. 모터가 브래킷에 너무 헐거우면 생성 스크립트의 `BRK_CLEAR` 를 0 으로, 너무 빡빡하면 0.4 로 바꿔 다시 출력합니다.

### 출력이 어려울 때

- **레이저 커팅**: 플레이트 3장은 2D 모양이므로 아크릴이나 포맥스(PVC 발포판)로 레이저 커팅할 수 있습니다. `part06_mech/dxf/plate_bottom.dxf` 같은 DXF 파일(단위 mm, 레이어 CUT)을 그대로 보냅니다. 판 두께 4 mm 를 구하기 어려우면 3 mm 또는 5 mm 를 쓰고 스크립트의 `PLATE_T` 를 바꿉니다 (볼트 길이는 그대로 써도 됩니다). 아크릴은 구멍 근처가 잘 깨지므로 볼트를 너무 세게 조이지 않습니다.
- **모터 브래킷**: 3D 모양이라 레이저 커팅이 안 됩니다. 출력 대행을 이용하거나, 시판 25 mm 기어드 모터용 금속 브래킷을 사고 하판의 B1 ~ B4 홀 위치를 그 브래킷의 홀 간격에 맞게 바꿉니다.
- **출력 대행**: 지역 메이커 스페이스(공공 무한상상실, 대학 창업 공간 등)의 3D 프린터를 쓰거나 온라인 3D 프린팅 출력 대행 서비스에 STL 4개(브래킷은 수량 2)와 위 설정표를 함께 보냅니다.

## 6-13 조립 순서

### 체결 부품 수량표

| 부품 | 규격 | 수량 | 사용처 |
|---|---|---|---|
| M4 서포트 | M4 x 50, 암-암 | 8 | 층간 (하판-중판 4, 중판-상판 4) |
| M4 볼트 | M4 x 16 | 8 | 하판 아래 4, 상판 위 4 |
| M4 무두볼트 | M4 x 12 | 4 | 중판에서 위아래 서포트를 잇는 용도 |
| M3 서포트 | M3 x 10, 수-암 | 8 | L298N 4, Uno 4 |
| M3 볼트 | M3 x 16 | 6 | 브래킷 고정 4, 클램프 2 |
| M3 볼트 | M3 x 6 | 8 | 서포트 위에 보드 고정 |
| M3 너트 | M3 | 14 | 브래킷 고정 4, 클램프 2, M3 서포트 아래 8 |
| 케이블타이 | 폭 3.6 mm 이하, 길이 300 mm | 2 | 배터리 홀더 |

M4 서포트가 수-암(수나사 한쪽) 형태라면 무두볼트 대신 아래 층 서포트의 수나사를 중판에 통과시켜 위 층 서포트에 바로 돌려 넣습니다. 암-암 서포트의 나사 깊이가 12 mm 보다 얕아 M4 x 16 이 바닥에 닿으면 M4 x 12 로 바꿉니다.

체결 길이 확인 (스크립트 검사 항목):

- 브래킷 고정: 하판 4 + 플랜지 5 + 너트 2.4 = 11.4 mm 이므로 M3 x 16 은 4.6 mm 남습니다.
- 클램프: 귀 12 + 너트 2.4 = 14.4 mm 이므로 M3 x 16 은 1.6 mm 남습니다.

### 순서

1. **하판 아랫면 + 브래킷**: 브래킷 2개를 하판 아랫면에 대고 하판 위에서 M3 x 16 을 B1 ~ B4 에 꽂아 플랜지 아래에서 너트로 조입니다. 아직 끝까지 조이지 않습니다.
2. **모터 끼우기**: 모터를 바깥에서 브래킷 구멍으로 밀어 넣어 기어박스 앞면이 판 가장자리에서 2 mm 안쪽에 오게 맞춥니다. 클램프 홀에 M3 x 16 과 너트를 넣고 모터가 손으로 돌지 않을 만큼 조입니다. 그 다음 1단계 볼트를 마저 조입니다. 모터 배선은 S1, S2 슬롯으로 위로 올립니다.
3. **하판 윗면 + L298N**: M3 x 10 수-암 서포트 4개의 수나사를 C1 ~ C4 에 꽂고 아랫면에서 M3 너트로 조인 뒤, L298N 을 올려 M3 x 6 으로 고정합니다. 방열판이 위로 오게 놓습니다.
4. **하판 층 서포트**: 모서리 A1 ~ A4 에 아래에서 M4 x 16 을 꽂아 M4 x 50 서포트 4개를 세웁니다.
5. **중판 + Uno**: 중판에 M3 x 10 서포트 4개를 U1 ~ U4 에 같은 방법으로 세우고 Uno 를 M3 x 6 으로 고정합니다. 중판을 하판 층 서포트 위에 얹고 M4 무두볼트로 위층 서포트 4개를 이어 세웁니다.
6. **상판 + 배터리, HC-05**: 상판을 위층 서포트에 얹고 M4 x 16 으로 고정합니다. 배터리 홀더를 가운데 놓고 케이블타이 2개로 T1-T3, T2-T4 를 감아 묶습니다. 배터리 선은 S1 슬롯으로 내립니다. HC-05 는 핀헤더를 H1 슬롯에 아래로 꽂고 양면테이프나 글루건으로 세워 고정합니다.
7. **바퀴**: 모터 축(D컷)에 바퀴 허브를 끼우고 고정 나사를 조입니다. 바퀴 안쪽 면과 판 가장자리 사이가 3 mm 정도인지 봅니다. 축이 허브에 물리는 길이는 약 7 mm 입니다.
8. **확인**: 로봇을 들고 바퀴를 손으로 돌려 어디에도 닿지 않는지, 바닥에 세웠을 때 앞뒤 어느 쪽으로도 심하게 기울지 않는지 봅니다.

MPU6050 은 배선 과정(Part 5)에서 정하는 위치에 붙입니다. 가능하면 바퀴 축과 가까운 하판이나 중판 중심선 위에 두어 바퀴 가속에 의한 잡음을 줄입니다.

조립 미리보기

## 6-14 제공 STL과 생성 스크립트 사용법 (치수 바꾸고 다시 생성)

Fusion 으로 직접 모델링하기 어렵거나 시간이 부족하면 제공된 STL 을 바로 출력해도 됩니다. 제공 STL 은 아래 스크립트로 만든 것입니다.

| 파일 | 외형 (mm) | 부피 (mm³) | watertight |
|---|---|---|---|
| `part06_mech/stl/plate_bottom.stl` | 120 x 75 x 4 | 34,706 | 예 |
| `part06_mech/stl/plate_middle.stl` | 120 x 75 x 4 | 34,659 | 예 |
| `part06_mech/stl/plate_top.stl` | 120 x 75 x 4 | 34,766 | 예 |
| `part06_mech/stl/motor_bracket.stl` (2개 출력) | 51 x 40.7 x 20 | 14,806 | 예 |

### 실행

필요한 패키지: Python 3, numpy, trimesh, manifold3d, matplotlib.

```
pip install numpy trimesh manifold3d matplotlib
python3 part06_mech/cad/generate.py
```

출력 앞부분은 다음과 같습니다.

```
== 1. 메시 생성 ==
[OK] plate_bottom     watertight=True  volume=True  bodies=1  부피  34705.9 mm^3  외형 120.0 x 75.0 x 4.0  (이론 부피 34705.0)  -> stl/plate_bottom.stl (198184 bytes)
...
== 3. 배치와 간섭 검사 ==
[OK] 하판 최소 살 두께 3.80 mm (기준 2.0)
[OK] 브래킷 M3 너트 / 몸통 간격 0.82 mm (기준 0.3)
[OK] 바퀴 X 구간 [-29.0, -3.0], 플레이트 [0, 120.0]: 겹침 없음, 간격 3.0 mm (기준 2.0)
[OK] 차체 최저점(브래킷 바닥) 지면 위 40.9 mm (기준 20.0)
[OK] 모터 축: 하판 아랫면에서 16.6 mm 아래, 지면에서 65.0 mm
...
== 4. 무게중심 ==
[OK] 몸체가 지면에 처음 닿는 기울기 100.5 도 (기준 45, 바퀴 Ø130 원 밖의 부품이 닿음)
  배터리 상판:  몸체 630 g, 축에서 무게중심까지 L = 69.3 mm, 시간상수 112 ms
...
결과: 모든 검사 통과
```

검사가 하나라도 실패(NG)하면 종료 코드 1 로 끝납니다.

### 스크립트 구조

| 절 | 내용 |
|---|---|
| 1. 치수 변수 | 플레이트, 모터, 바퀴, 브래킷, 전장품 치수와 질량 추정값. **여기만 고칩니다** |
| 2. 파생 치수 | 축 높이, 각 판의 높이, Uno 원점 등을 계산 |
| 3. 형상 정의 | 판마다 구멍과 슬롯 목록(`Feature`). 메시, 도면, DXF, 검사가 모두 이 목록을 공유 |
| 4. 메시 생성 | trimesh 로 상자와 원통을 만들고 manifold 엔진으로 빼기(difference) |
| 5. 검사 | 살 두께, 부품 간격, 바퀴와 판의 X 구간, 지면 여유, 볼트 길이 |
| 6. 조립 모델 | 바퀴, 모터, 서포트를 원통으로 배치, 무게중심과 τ 계산 |
| 7. DXF | 레이저 커팅용 외곽선 |
| 8. 그림 | 도면 PNG 와 조립 미리보기 PNG |

### 치수를 바꾸는 예: 37 mm 모터로 바꾸기

가지고 있는 모터가 37 mm 기어드 모터라면 `MOTOR_D = 37.0` 만 바꾸고 실행해 봅니다.

```
[NG] 브래킷 M3 너트 / 몸통 간격 -5.18 mm (기준 0.3)
결과: 실패 항목이 있습니다. 치수를 확인하세요
```

몸통이 넓어져 플랜지 고정 너트 자리가 사라졌습니다. 플랜지를 넓히려고 `BRK_FLANGE_W = 63.0`, `BRK_MOUNT_PITCH = 54.0` 으로 바꾸면 다음 문제가 나옵니다.

```
[NG] 하판 아랫면 브래킷 / M4 볼트 머리 간격 -3.50 mm (기준 1.0)
```

넓어진 플랜지가 모서리 M4 볼트 머리와 겹칩니다. 브래킷을 안쪽으로 옮기기 위해 `BRK_FACE_GAP = 9.0` 으로 바꾸면 모두 통과하고, 축이 하판 아래 22.6 mm 로 내려가며 하판의 B 홀 위치와 도면도 자동으로 바뀝니다. 실제로는 37 mm 모터의 길이도 다르므로 `MOTOR_LEN` 도 재서 넣습니다. 이처럼 값 하나를 바꿨을 때 어디가 영향을 받는지 검사 결과가 알려 주는 것이 파라메트릭 설계의 장점입니다. Fusion 에서도 MODIFY > Change Parameters 로 같은 방식의 설계를 할 수 있습니다.

다른 자주 바꾸는 값:

| 상황 | 바꿀 변수 |
|---|---|
| 바퀴 지름이 다름 | `WHEEL_D`, `WHEEL_W` (지면 여유와 축 높이 검사가 다시 계산됨) |
| 배터리 홀더 크기가 다름 | `BATT_HOLDER`, `TIE_SLOT_GAP` |
| 레이저 커팅용 3 mm 판 | `PLATE_T` |
| 모터가 브래킷에 헐겁거나 빡빡함 | `BRK_CLEAR` |
| 층간 서포트 길이가 다름 | `SUPPORT_LEN` (무게중심과 τ 가 다시 계산됨) |

바꾼 뒤에는 `part06_mech/img/` 의 도면 그림을 열어 숫자가 의도대로 바뀌었는지 확인하고 출력합니다.

### 전체 스크립트

<!-- include: part06_mech/cad/generate.py -->
