hjunhuh/balancebot-course/part01_orientation/README.md

# Part 1. 오리엔테이션

## 1-01 이 과정에서 만드는 것

스스로 균형을 잡고 스마트폰으로 조종하는 **2륜 밸런싱 로봇**을 처음부터 끝까지 혼자 만듭니다. 단순히 따라 만드는 것이 아니라, 양산 제품 개발처럼 요구사항을 정하고, HW, 기구, 펌웨어, 앱을 설계하고, 테스트로 검증한 뒤, 그 과정을 포트폴리오로 정리합니다.

| 파트 | 내용 | 결과물 | 예상 시간 |
|---|---|---|---|
| 1 | 오리엔테이션 | 학습 계획, 준비물 | 0.5 h |
| 2 | 임베디드 Basic C | PC 실습 18개 | 4 h |
| 3 | ATmega328P 레지스터 프로그래밍 | 보드 실습 15개 | 8 h |
| 4 | 개발 프로세스와 설계 | 요구사항, HSI, SW 아키텍처, Git | 2 h |
| 5 | HW (KiCad) | 쉴드 회로도, PCB, 거버, 발주 | 5 h |
| 6 | 기구 (Fusion 360) | 플레이트 3장, 모터 브래킷, STL | 3 h |
| 7 | 앱 (Android Studio) | 블루투스 조종, 튜닝 앱 | 3 h |
| 8 | 펌웨어 (Microchip Studio) | BSW/DRV/ASW 펌웨어, 시뮬레이터 | 5 h |
| 9 | 통합 테스트 | 테스트 14개, 튜닝 기록 | 1 h 이상 |
| 10 | 포트폴리오 | 포트폴리오 PDF, 이력서 문구 | 1 h |

시간은 읽고 따라 하는 최소 시간입니다. 하드웨어 조립, PCB 배송 대기, 튜닝은 별도입니다.

## 1-02 추천 진행 일정 (6 주)

| 주 | 할 일 | 병행 |
|---|---|---|
| 1 | Part 2 전체, 부품 주문 | |
| 2 | Part 3 lab01~lab08 | Part 4 읽기 |
| 3 | Part 3 lab09~lab15, Part 4 산출물 작성 | Part 5 회로도 |
| 4 | Part 5 PCB 완성, **발주** | Part 6 모델링, 3D 출력 |
| 5 | Part 7 앱, Part 8 펌웨어 (PCB 오기 전 브레드보드로 확인) | |
| 6 | PCB 조립, Part 9 통합과 튜닝, Part 10 정리 | |

PCB 제작과 배송에 1~2 주가 걸리므로 4 주차에 반드시 발주합니다. 기다리는 동안 같은 넷 리스트로 브레드보드에서 펌웨어를 먼저 검증합니다.

## 1-03 사전 지식

- 프로그래밍 경험이 없어도 Part 2 부터 시작하면 됩니다. 있으면 Part 2 는 빠르게 넘깁니다.
- 회로이론, 제어공학 지식은 있으면 좋지만 필수는 아닙니다. 필요한 만큼 각 파트에서 설명합니다.
- 가장 중요한 것은 데이터시트와 문서를 직접 찾아보는 습관입니다.

## 1-04 준비물

### 소프트웨어 (모두 무료)

| 도구 | 용도 | 파트 |
|---|---|---|
| Dev-C++ 또는 gcc | C 실습 | 2 |
| Microchip Studio 7 | AVR 펌웨어 빌드, 기록 | 3, 8 |
| Tinkercad Circuits (웹) | 하드웨어 없이 시뮬레이션 | 3 |
| KiCad 9 | 회로도, PCB | 5 |
| Fusion 360 (개인용 무료) | 3D 모델링 | 6 |
| Android Studio | 앱 | 7 |
| Git, GitLab 계정, Fork (Git GUI) | 형상 관리 | 4 |
| 휴대폰 시리얼 블루투스 터미널 앱 | 통신 확인 | 3, 9 |

### 하드웨어

| 분류 | 품목 | 수량 |
|---|---|---|
| 실습 | Arduino Uno 호환 보드가 들어 있는 입문 키트 (LED, 저항, 버튼, 가변저항, 브레드보드, 점퍼선) | 1 |
| 실습 | AVRISP mkII 호환 ISP 프로그래머 | 1 |
| 로봇 | MPU6050 모듈 (GY-521) | 1 |
| 로봇 | HC-05 블루투스 모듈 | 1 |
| 로봇 | L298N 듀얼 모터 드라이버 모듈 | 1 |
| 로봇 | 25 mm 기어드 DC 모터 (축 4 mm) | 2 |
| 로봇 | 130 mm 바퀴와 4 mm 허브 | 2 |
| 로봇 | 18650 리튬이온 셀과 충전기 | 4 셀 |
| 로봇 | 18650 4구 홀더 (2S2P 배선) | 1 |
| 로봇 | 토글 또는 로커 전원 스위치 | 1 |
| 기구 | M4 x 50 서포트 (암수, 암암), M4 x 16 볼트, M3 x 16 볼트, M3 x 10 서포트, M3 너트 | Part 6 수량표 |
| 기구 | 3D 프린팅 (직접 또는 출력 대행) | 플레이트 3, 브래킷 2 |
| PCB | 쉴드 PCB 발주와 부품 | Part 5 BOM |
| 공구 | 납땜 인두, 멀티미터, 드라이버, 니퍼 | |

18650 셀은 보호회로가 있는 제품을 쓰고, 전용 충전기로만 충전합니다. 단락되면 큰 전류가 흘러 위험합니다.

## 1-05 저장소 사용법

```
balancebot-course/
  SPEC.md            모든 파트가 따르는 공통 사양 (핀맵, 프로토콜, 치수)
  part01_orientation/
  part02_c/          C 실습 18개 + Makefile
  part03_avr/        AVR 실습 15개 + Makefile
  part04_design/     요구사항, HSI, 추적성 (CSV 포함)
  part05_hw/         회로 설계 문서, BOM, 블록 다이어그램
  part06_mech/       STL, 도면 PNG, 파라메트릭 생성 스크립트
  part07_app/        Android 앱 소스
  part08_fw/         밸런싱 로봇 펌웨어, 단위 테스트, 시뮬레이터
  part09_test/       통합 테스트 명세, 결과 보고서 템플릿
  part10_portfolio/  포트폴리오 템플릿
```

각 파트 폴더의 README 가 강의 본문입니다. 학습 사이트는 이 README 들을 모아 만든 것이라 내용이 같습니다.

## 1-06 이 과정의 학습 방식

1. **사양 먼저**: `SPEC.md` 의 핀맵과 프로토콜은 HW, 펌웨어, 앱이 모두 공유합니다. 무언가 바꾸면 이 문서부터 고칩니다.
2. **작게 확인하고 붙이기**: Part 3 의 실습 하나하나가 Part 8 의 모듈 하나가 됩니다. 보드에서 하나씩 동작을 확인한 뒤 합칩니다.
3. **보드 전에 PC**: 제어 알고리즘은 Part 8 의 PC 시뮬레이터로 먼저 검증합니다. 로봇이 넘어지는 이유가 코드인지 하드웨어인지 구분할 수 있게 됩니다.
4. **모든 단계를 기록**: 커밋 메시지, 튜닝 기록, 테스트 결과가 그대로 포트폴리오가 됩니다.

## 1-07 AI 도구(ChatGPT, Claude 등) 활용 원칙

AI 는 레지스터 설정 초안, 레이아웃 XML 초안, 오류 메시지 해석에 유용합니다. 다만 다음을 지킵니다.

- 받은 코드의 레지스터 이름, 비트 위치, 계산값은 **반드시 데이터시트와 대조**합니다 (Part 3 3-02 체크리스트).
- 이해하지 못한 코드는 넣지 않습니다. "이 줄이 왜 필요한가요?" 라고 다시 묻습니다.
- 질문할 때 SPEC 의 핀맵과 클럭(16 MHz), MCU 이름을 함께 줍니다.
