hjunhuh/balancebot-course/SPEC.md

# 공통 사양서 (모든 파트가 따르는 기준)

이 문서는 과정 전체에서 공유하는 하드웨어 핀맵, 통신 프로토콜, 폴더 규칙, 작성 규칙을 정의합니다. 파트별 코드와 문서는 반드시 이 값을 그대로 사용합니다.

## 1. 대상 하드웨어

| 항목 | 내용 |
|---|---|
| MCU 보드 | Arduino Uno R3 (ATmega328P, 16 MHz 외부 크리스탈) |
| 프로그래머 | AVRISP mkII (Uno의 6핀 ICSP 헤더에 연결) |
| IDE | Microchip Studio 7 (GCC C Executable Project, Device: ATmega328P) |
| 클럭 | F_CPU = 16000000UL |
| 퓨즈 | 변경하지 않음 (Uno 출고값 Low 0xFF, High 0xDE, Ext 0xFD) |
| IMU | MPU6050 모듈 (GY-521), I2C 주소 0x68 |
| 블루투스 | HC-05 (데이터 모드 9600 bps, 8N1) |
| 모터 드라이버 | L298N 듀얼 H브리지 모듈 |
| 모터 | 25 mm 기어드 DC 모터 (축 4 mm) 2개, 130 mm 바퀴 |
| 배터리 | 18650 4개, 2S2P (공칭 7.4 V, 만충 8.4 V) |

주의: AVRISP mkII로 ISP 기록하면 Uno의 부트로더가 지워집니다. 이후 Arduino IDE의 USB 업로드를 다시 쓰려면 Arduino IDE의 "부트로더 굽기"를 실행합니다.

## 2. 핀맵 (HSI 기준값)

| Uno 핀 | AVR 핀 | 방향 | 신호 | 연결 대상 |
|---|---|---|---|---|
| D0 | PD0 / RXD0 | 입력 | BT_RX | HC-05 TXD |
| D1 | PD1 / TXD0 | 출력 | BT_TX | HC-05 RXD (1k/2k 분압, 5V를 3.3V로) |
| D2 | PD2 / INT0 | 입력 | IMU_INT | MPU6050 INT (예비, v1 미사용) |
| D3 | PD3 / INT1 | 입력 | BTN | 푸시버튼, GND로 연결, 내부 풀업 |
| D4 | PD4 | 출력 | MR_IN3 | L298N IN3 (오른쪽 모터 방향) |
| D5 | PD5 / OC0B | 출력 | MR_PWM | L298N ENB (오른쪽 모터 속도) |
| D6 | PD6 / OC0A | 출력 | ML_PWM | L298N ENA (왼쪽 모터 속도) |
| D7 | PD7 | 출력 | ML_IN1 | L298N IN1 (왼쪽 모터 방향) |
| D8 | PB0 | 출력 | ML_IN2 | L298N IN2 (왼쪽 모터 방향) |
| D9 | PB1 | 출력 | MR_IN4 | L298N IN4 (오른쪽 모터 방향) |
| D10 | PB2 | 출력 | LED_STAT | 상태 LED (330 옴 직렬) |
| A0 | PC0 / ADC0 | 아날로그 | VBAT_SENSE | 배터리 분압 (상단 20k, 하단 10k, 100nF) |
| A4 | PC4 / SDA | 양방향 | I2C_SDA | MPU6050 SDA |
| A5 | PC5 / SCL | 출력 | I2C_SCL | MPU6050 SCL |

모터 정의: 왼쪽 모터 = L298N OUT1/OUT2 (ENA, IN1, IN2), 오른쪽 모터 = OUT3/OUT4 (ENB, IN3, IN4).
방향 규칙: IN1=1, IN2=0 이면 왼쪽 정방향, IN3=1, IN4=0 이면 오른쪽 정방향. 실제 배선에 따라 반대로 돌면 펌웨어 설정 매크로(MOTOR_L_INVERT, MOTOR_R_INVERT)로 맞춥니다.

## 3. 주변장치 설정 기준값

| 기능 | 설정 |
|---|---|
| Timer0 | Fast PWM 8bit, 분주 8, 7812.5 Hz, OC0A/OC0B 비반전 |
| Timer1 | CTC, 분주 64, OCR1A = 249, 1 ms 틱 인터럽트 |
| 제어 주기 | 5 ms (200 Hz) |
| UART0 | 9600 bps, U2X0 = 1, UBRR0 = 207, 8N1 |
| TWI | 400 kHz, TWBR = 12, 분주 1 |
| ADC | AVcc 기준, 분주 128 |
| MPU6050 | PWR_MGMT_1=0x01, SMPLRT_DIV=4, CONFIG=3, GYRO ±250 dps (131 LSB/dps), ACCEL ±2 g (16384 LSB/g) |

## 4. 블루투스 프로토콜 v1

ASCII 한 줄 단위 프레임입니다. 시리얼 터미널로도 사람이 읽고 보낼 수 있게 설계했습니다.

```
앱 -> 로봇 : $<TYPE>[,<필드>...]*<HH>\n
로봇 -> 앱 : #<TYPE>[,<필드>...]*<HH>\n
```

- HH: 시작 문자($ 또는 #) 다음부터 `*` 직전까지 모든 바이트의 XOR 값, 대문자 16진수 2자리
- 필드는 10진 정수만 사용합니다 (실수는 100배 정수)
- 프레임 최대 길이 48바이트, `\r`은 무시합니다

| 방향 | 프레임 | 의미 | 범위 |
|---|---|---|---|
| 앱 -> 로봇 | `$D,x,y` | 조이스틱 (x: 회전 +오른쪽, y: 전진 +앞) | -100..100 |
| 앱 -> 로봇 | `$P,kp,ki,kd` | PID 게인 x100 | 0..100000 |
| 앱 -> 로봇 | `$T,trim` | 기준 각도 보정 x100 (도) | -1000..1000 |
| 앱 -> 로봇 | `$V,ks` | 속도 보상 게인 x100 | 0..100000 |
| 앱 -> 로봇 | `$M,e` | 모터 허용 1, 정지 0 | 0..1 |
| 앱 -> 로봇 | `$S` | 현재 파라미터 EEPROM 저장 | |
| 앱 -> 로봇 | `$G` | 파라미터 요청 | |
| 로봇 -> 앱 | `#A,angle,out,mv,st` | 10 Hz 텔레메트리 (각도 x100, 모터 출력 -255..255, 배터리 mV, 상태 번호) | |
| 로봇 -> 앱 | `#K,kp,ki,kd,trim,ks` | 파라미터 보고 ($G, $P, $T, $V, $S 처리 후) | |
| 로봇 -> 앱 | `#O,c` | 명령 c 처리 완료 (c는 아스키 코드 값이 아니라 문자 그대로, 예 `#O,S`) | |
| 로봇 -> 앱 | `#E,n` | 오류 1 체크섬, 2 형식, 3 범위, 4 알 수 없는 명령 | |

조이스틱은 터치 중 50 ms 마다 `$D`를 보내고, 손을 떼면 `$D,0,0`을 보냅니다. 로봇은 500 ms 동안 `$D`를 못 받으면 조이스틱 값을 0으로 간주합니다.

상태 번호: 0 INIT, 1 CALIB, 2 WAIT_UPRIGHT, 3 BALANCE, 4 FALLEN, 5 IDLE(모터 정지 명령), 6 LOW_BATT

체크섬 예: `$G*47` (G = 0x47), `$M,1*` 다음은 `M`,`,`,`1` 의 XOR = 0x4D^0x2C^0x31 = 0x50 이므로 `$M,1*50`.

## 5. 기구 기준 치수

- 플레이트 3장(하판, 중판, 상판) 120 x 75 x 4 mm, 모서리 M4 관통홀 4개 (구멍 지름 4.4 mm, 모서리에서 6 mm 안쪽)
- 층간 M4 x 50 mm 서포트
- 하판: 모터 브래킷 2개, L298N 장착 (L298N 모듈 홀 간격 37 x 37 mm, M3)
- 중판: Arduino Uno + 쉴드 (Uno 홀 좌표 mm: (13.97, 2.54), (15.24, 50.80), (66.04, 7.62), (66.04, 35.56), M3 x 10 서포트)
- 상판: 4구 18650 홀더 (케이블타이 슬롯)
- 무게중심을 높게 두면 넘어지는 속도가 느려져 제어가 쉬워지므로 배터리를 상판에 둡니다

## 6. 폴더와 작성 규칙

- 각 파트 폴더의 `README.md` 가 그 파트의 강의 본문입니다. 학습 사이트는 이 파일들을 그대로 모아 만듭니다.
- 본문에서 코드 파일 전체를 보여줄 때는 코드를 복사하지 말고 한 줄에 `<!-- include: 경로 -->` 를 씁니다 (경로는 저장소 루트 기준, 예 `part02_c/04_bitwise.c`). 사이트 빌드 시 코드 블록으로 치환됩니다.
- 문체: 한국어 합니다체. 엠대시 문자와 가운뎃점 문자는 문서와 주석 어디에도 쓰지 않습니다 (쉼표, 괄호, 콜론으로 대체).
- 모든 코드는 이 환경에서 실제로 빌드 또는 실행하여 확인합니다 (C는 gcc, AVR은 avr-gcc -mmcu=atmega328p -Os, Python은 python3, Java 순수 로직은 javac).
