hjunhuh/balancebot-course/part07_app/README.md

# Part 7. 밸런싱로봇용 App 개발 with Android Studio

이 파트에서는 휴대폰으로 밸런싱 로봇을 조종하고 PID 게인을 튜닝하는 Android 앱을 만듭니다. 앱은 HC-05 블루투스 모듈과 SPP(시리얼 포트 프로파일)로 연결하고, 공통 사양서(SPEC.md) 4장의 블루투스 프로토콜 v1 을 글자 그대로 따릅니다.

이 폴더의 구성은 다음과 같습니다.

| 경로 | 내용 |
|---|---|
| `app/src/main/java/com/example/balancebot/MainActivity.java` | 화면 하나짜리 앱의 Activity |
| `app/src/main/java/com/example/balancebot/BluetoothService.java` | 블루투스 연결, 송신, 수신 스레드 |
| `app/src/main/java/com/example/balancebot/JoystickView.java` | Canvas 로 직접 그리는 조이스틱 |
| `app/src/main/java/com/example/balancebot/Protocol.java` | 프레임 생성, 체크섬, 파싱 (Android 의존성 없음) |
| `app/src/main/res/layout/activity_main.xml` | 화면 레이아웃 |
| `app/src/main/res/values/strings.xml`, `themes.xml` | 문자열, 테마와 스타일 |
| `app/src/main/AndroidManifest.xml` | 권한과 Activity 선언 |
| `build.gradle`, `settings.gradle`, `gradle.properties`, `app/build.gradle`, `gradle/wrapper/gradle-wrapper.properties` | Gradle 설정 (AGP 8.5.2, Gradle 8.7, Groovy DSL) |
| `test/ProtocolTest.java` | PC 에서 javac 로 돌리는 프로토콜 테스트 |

## 7-01 앱이 하는 일과 화면 설계

앱이 하는 일은 네 가지입니다.

1. 페어링된 HC-05 에 연결하고, 끊기면 화면에 알립니다.
2. 조이스틱으로 로봇을 움직입니다. 터치 중에는 50 ms 마다 `$D,x,y` 를 보내고, 손을 떼면 `$D,0,0` 을 보냅니다.
3. PID 게인(Kp, Ki, Kd), 기준 각도 보정(Trim), 속도 보상 게인(Ks)을 읽고, 바꾸고, EEPROM 에 저장합니다.
4. 로봇이 10 Hz 로 보내는 텔레메트리(`#A`)를 받아 각도, 모터 출력, 배터리 전압, 상태를 보여 줍니다.

화면은 위에서 아래로 한 줄씩 쌓는 단순한 구조입니다. 화면이 작은 휴대폰에서도 잘리지 않도록 전체를 ScrollView 로 감쌉니다. 아래 표가 와이어프레임입니다.

| 순서 | 구역 | 위젯 (id) | 동작 |
|---|---|---|---|
| 0 | 제목 | TextView "BalanceBot" | 표시만 |
| 1 | 연결 | TextView `tvConnState` | "연결 안 됨", "연결 중: HC-05", "연결됨: HC-05" |
| 1 | 연결 | Button `btnConnect` [연결], Button `btnDisconnect` [끊기] (가로 반반) | 권한 확인 후 페어링 목록 다이얼로그, 연결 해제 |
| 2 | 모터 | SwitchCompat `switchMotor` "모터 허용" | 켜면 `$M,1`, 끄면 `$M,0` |
| 3 | 텔레메트리 | `tvAngle` 각도, `tvOutput` 출력 (1행) | `#A` 수신 시 갱신 |
| 3 | 텔레메트리 | `tvBattery` 배터리, `tvState` 상태 (2행) | `#A` 수신 시 갱신 |
| 4 | 조이스틱 | JoystickView `joystick` (240 dp 정사각형) | 터치 중 50 ms 마다 `$D` |
| 4 | 조이스틱 | TextView `tvJoyValue` "x 0, y 0" | 현재 조이스틱 값 |
| 5 | PID 튜닝 | 라벨 + EditText `etKp`, `etKi`, `etKd`, `etTrim`, `etKs` (5행) | 소수 둘째 자리까지 입력 |
| 5 | PID 튜닝 | Button `btnSendParams` [보내기], `btnReadParams` [읽기], `btnSaveParams` [저장] (가로 3등분) | `$P`,`$T`,`$V` 순서 전송 / `$G` / `$S` |
| 6 | 수신 확인 | TextView `tvLastRx` 마지막 수신 줄, `tvRxStats` 정상/무시 줄 수 | 디버그용 |

화면 그림으로 보면 다음과 같습니다.

```
+----------------------------------+
| BalanceBot                       |
| 연결                             |
| 연결됨: HC-05                    |
| [   연결   ]  [   끊기   ]       |
| 모터 허용                  (O-)  |
| 텔레메트리                       |
| 각도: -1.25 도   출력: 40        |
| 배터리: 7.60 V   상태: 3 BALANCE |
| 조이스틱                         |
|            .------.              |
|          /    |     \            |
|         |----(O)----|            |
|          \    |     /            |
|            '------'              |
|            x 0, y 0              |
| PID 튜닝                         |
| Kp  [ 25.00            ]         |
| Ki  [ 0.10             ]         |
| Kd  [ 0.80             ]         |
| Trim[ -1.50            ]         |
| Ks  [ 12.00            ]         |
| [보내기]  [읽기]  [저장]         |
| 수신 확인                        |
| #A,-125,40,7600,3*..             |
| 정상 120 줄, 무시 0 줄           |
+----------------------------------+
```

연결 전에는 [끊기], 모터 스위치, PID 버튼 세 개가 비활성화됩니다. 연결되면 앱이 자동으로 `$G` 를 보내 로봇의 현재 파라미터를 받아 입력칸을 채웁니다.

## 7-02 Android Studio 설치와 새 프로젝트 만들기

### Android Studio 설치

1. https://developer.android.com/studio 에서 Android Studio 를 내려받아 설치합니다. Windows 는 설치 마법사의 기본값 그대로 진행하면 됩니다.
2. 처음 실행하면 Setup Wizard 가 나옵니다. Standard 를 고르면 Android SDK, SDK Platform-Tools, 에뮬레이터, 최신 Android SDK Platform 이 함께 설치됩니다.
3. 설치 후 Welcome 화면의 More Actions, SDK Manager 에서 SDK Platforms 탭의 Android 14.0 (API 34) 이 설치되어 있는지 확인합니다. 없으면 체크하고 Apply 를 누릅니다.
4. 같은 창의 SDK Tools 탭에서 Android SDK Build-Tools, Android SDK Platform-Tools 가 설치되어 있는지 확인합니다.

블루투스는 에뮬레이터에서 동작하지 않으므로 이 파트의 테스트는 반드시 실제 휴대폰으로 합니다.

### 새 프로젝트 만들기

1. Welcome 화면에서 New Project 를 누릅니다.
2. Phone and Tablet 탭에서 **Empty Views Activity** 를 고릅니다. (Empty Activity 는 Jetpack Compose 템플릿이므로 고르지 않습니다.)
3. 다음 값을 입력합니다.

| 항목 | 값 |
|---|---|
| Name | BalanceBot |
| Package name | com.example.balancebot |
| Save location | 원하는 폴더 |
| Language | Java |
| Minimum SDK | API 23 ("Marshmallow"; Android 6.0) |
| Build configuration language | Groovy DSL (build.gradle) 권장, Kotlin DSL 이어도 아래 방법으로 그대로 됩니다 |

4. Finish 를 누르고 Gradle Sync 가 끝날 때까지 기다립니다 (처음에는 몇 분 걸립니다). 이 상태에서 한 번 Run 해서 빈 화면 앱이 뜨는지 확인해 두면 이후 문제를 나누어 보기 좋습니다.

Name 을 꼭 `BalanceBot` 으로 하세요. 템플릿이 만드는 테마 이름이 `Theme.BalanceBot` 이 되고, 이 폴더의 매니페스트도 같은 이름을 씁니다.

### 이 폴더의 파일로 덮어쓰기

Gradle 파일까지 통째로 덮어쓰면 Android Studio 버전에 따라 버전 카탈로그(libs.versions.toml)나 Kotlin DSL 과 섞여 동기화가 실패하기 쉽습니다. 가장 확실한 방법은 **Android Studio 가 만든 프로젝트와 Gradle 설정은 그대로 두고, 소스와 리소스만 교체**하는 것입니다. Empty Views Activity 템플릿에는 이미 appcompat 과 material 의존성이 들어 있으므로 Gradle 은 건드릴 필요가 없습니다.

Android Studio 왼쪽 위 보기 방식을 Android 에서 **Project** 로 바꾸면 실제 폴더 구조가 보입니다. 아래 표대로 복사합니다 (`<프로젝트>` 는 새로 만든 BalanceBot 폴더).

| 이 폴더의 파일 | 복사할 위치 | 방법 |
|---|---|---|
| `app/src/main/java/com/example/balancebot/MainActivity.java` | `<프로젝트>/app/src/main/java/com/example/balancebot/` | 덮어쓰기 |
| `BluetoothService.java`, `JoystickView.java`, `Protocol.java` | 같은 폴더 | 새로 추가 |
| `app/src/main/res/layout/activity_main.xml` | `<프로젝트>/app/src/main/res/layout/` | 덮어쓰기 |
| `app/src/main/res/values/strings.xml` | `<프로젝트>/app/src/main/res/values/` | 덮어쓰기 |
| `app/src/main/res/values/themes.xml` | `<프로젝트>/app/src/main/res/values/` | 덮어쓰기 |
| `app/src/main/AndroidManifest.xml` | `<프로젝트>/app/src/main/` | 덮어쓰기 |

복사한 다음 아래 정리를 합니다.

1. `<프로젝트>/app/src/main/res/values-night/themes.xml` 을 삭제합니다. 템플릿의 다크 모드 테마이며, 우리 테마는 DayNight 라서 따로 필요 없습니다.
2. 메뉴 Build, Clean Project 를 실행한 뒤 File, Sync Project with Gradle Files 를 누릅니다.
3. 빨간 줄이 남아 있으면 7-13 의 체크리스트를 봅니다.

이 폴더의 Gradle 파일(`build.gradle`, `app/build.gradle` 등)은 "이 앱에 필요한 설정이 무엇인가"를 보여 주는 참고본입니다. 템플릿 Gradle 의 `namespace`, `applicationId` 가 `com.example.balancebot` 이고, `minSdk` 23, `compileSdk` 34 이상이며, 의존성에 appcompat 과 material 이 있는지만 비교해서 확인하면 됩니다.

## 7-03 Android 프로젝트 구조

Android 앱은 다음 다섯 가지 요소로 이루어집니다.

| 요소 | 이 프로젝트의 파일 | 역할 |
|---|---|---|
| Activity | `MainActivity.java` | 화면 하나를 담당하는 클래스. `onCreate()` 에서 레이아웃을 붙이고 버튼 동작을 연결합니다 |
| 레이아웃 XML | `res/layout/activity_main.xml` | 화면에 어떤 위젯을 어떤 순서로 놓을지 정의합니다. 각 위젯의 `android:id` 로 Java 에서 찾습니다 |
| 리소스 | `res/values/strings.xml`, `themes.xml` | 문자열, 색, 스타일을 코드 밖에 둡니다. 빌드하면 `R.string.xxx`, `R.style.xxx` 같은 정수 상수가 생깁니다 |
| 매니페스트 | `AndroidManifest.xml` | 앱 이름, 아이콘, 테마, 권한, 첫 화면(LAUNCHER Activity)을 시스템에 알립니다 |
| Gradle | `build.gradle`, `settings.gradle` 등 | 컴파일 SDK, 최소 SDK, 라이브러리 의존성, 빌드 방법을 정합니다 |

레이아웃과 Java 코드는 `R` 클래스로 이어집니다. 레이아웃에 `android:id="@+id/btnConnect"` 라고 쓰면 빌드할 때 `R.id.btnConnect` 상수가 만들어지고, Java 에서 `findViewById(R.id.btnConnect)` 로 그 버튼 객체를 얻습니다. id 철자가 하나라도 다르면 컴파일 오류가 나므로, 레이아웃을 고친 뒤에는 Java 쪽 id 도 같이 확인합니다.

이 앱의 Java 클래스 관계는 다음과 같습니다.

| 클래스 | 아는 것 | 모르는 것 |
|---|---|---|
| `Protocol` | 프레임 문자열, 체크섬, 숫자 변환 | Android, 블루투스, 화면 |
| `BluetoothService` | 소켓, 스레드, 바이트를 줄로 모으기 | 화면 위젯 |
| `JoystickView` | 터치 좌표, 그리기 | 블루투스, 프로토콜 형식 |
| `MainActivity` | 위 셋을 연결하고 화면을 갱신 | 소켓 세부 동작 |

`Protocol` 을 Android 와 분리해 둔 덕분에 휴대폰 없이 PC 에서 javac 로 테스트할 수 있습니다 (7-08).

## 7-04 ChatGPT로 레이아웃 설계하기

레이아웃 XML 은 반복이 많아 생성형 AI 의 도움을 받기 좋은 부분입니다. 다만 AI 가 만든 코드는 그럴듯해 보여도 id 가 다르거나, 쓰지 않기로 한 라이브러리를 끌어오는 일이 잦습니다. 그래서 **조건을 구체적으로 주고, 받은 결과를 정해진 순서로 검증**하는 습관이 중요합니다.

### 프롬프트 예

아래는 실제로 쓸 수 있는 프롬프트입니다. 7-01 의 와이어프레임 표를 그대로 붙여 넣는 것이 핵심입니다.

```
Android 앱 레이아웃 XML(activity_main.xml)을 만들어 주세요.

조건:
- 루트는 ScrollView, 그 안에 세로 LinearLayout 하나. ConstraintLayout 은 쓰지 마세요.
- 외부 라이브러리 금지. appcompat, material 만 사용합니다.
- 모든 문자열은 @string/ 리소스로 빼고, 필요한 strings.xml 항목도 함께 주세요.
- 아래 id 를 정확히 이 철자로 써 주세요. 다른 id 는 추가하지 마세요.
  tvConnState, btnConnect, btnDisconnect, switchMotor(androidx.appcompat.widget.SwitchCompat),
  tvAngle, tvOutput, tvBattery, tvState,
  joystick(커스텀 뷰 com.example.balancebot.JoystickView, 240dp 정사각형, 가운데 정렬), tvJoyValue,
  etKp, etKi, etKd, etTrim, etKs (inputType numberDecimal, etTrim 은 numberSigned 도),
  btnSendParams, btnReadParams, btnSaveParams, tvLastRx, tvRxStats
- 화면 구성(위에서 아래):
  (7-01 의 와이어프레임 표를 여기에 붙여 넣기)
- 같은 속성이 반복되는 구역 제목, 텔레메트리 값, 파라미터 라벨과 입력칸은 themes.xml 의 style 로 묶어 주세요.
```

### 받은 결과를 검증하는 법

AI 답변을 받으면 아래 순서로 확인합니다. 하나라도 걸리면 그 부분을 지적해서 다시 요청하거나 직접 고칩니다.

1. **루트와 금지 항목**: `ScrollView` 가 루트인지, `androidx.constraintlayout`, `app:layout_constraint` 같은 문자열이 없는지 찾기(Ctrl+F)로 확인합니다.
2. **id 대조**: 프롬프트에 준 id 목록과 XML 의 `@+id/` 를 하나씩 대조합니다. `btn_connect` 처럼 표기법을 멋대로 바꾸는 경우가 많습니다. 이 저장소 작업에서는 레이아웃의 `@+id` 목록과 Java 의 `R.id.` 목록을 스크립트로 뽑아 서로 빠진 것이 없는지 비교했습니다. 같은 일을 손으로 하려면 Android Studio 에서 Ctrl+Shift+F 로 `R.id.` 를 검색해 목록을 비교합니다.
3. **리소스 존재**: XML 의 `@string/xxx`, `@style/xxx` 가 모두 strings.xml, themes.xml 에 있는지 봅니다. 없는 리소스는 Android Studio 가 빨간색으로 표시합니다.
4. **위젯 종류**: Java 가 `SwitchCompat` 으로 받는데 XML 이 `Switch` 이면 실행 중 ClassCastException 으로 앱이 죽습니다. 커스텀 뷰는 패키지 이름까지 정확해야 합니다.
5. **Design 탭 미리보기**: 레이아웃 파일을 열고 오른쪽 위 Split 또는 Design 을 눌러 와이어프레임과 같은 순서로 보이는지 확인합니다.
6. **실행**: 마지막으로 휴대폰에서 실행해 스크롤, 키보드가 올라올 때 입력칸 가림 여부를 봅니다.

AI 가 레이아웃만 주고 Java 를 주지 않았다면, 레이아웃이 Java 와 맞는지 확인하는 책임은 우리에게 있다는 점을 기억하세요.

## 7-05 레이아웃 XML

전체 레이아웃입니다. 구역마다 제목 TextView 를 두고, 가로로 나란히 놓을 위젯은 가로 LinearLayout 에 `layout_width="0dp"`, `layout_weight="1"` 을 주어 같은 너비로 나눕니다.

<!-- include: part07_app/app/src/main/res/layout/activity_main.xml -->

눈여겨볼 점은 다음과 같습니다.

- `style="@style/SectionTitle"` 처럼 반복되는 속성은 themes.xml 의 스타일로 묶었습니다. 스타일 안에 `layout_width`, `layout_height` 를 넣었기 때문에 위젯 쪽에서는 생략해도 됩니다.
- `com.example.balancebot.JoystickView` 는 우리가 만든 커스텀 뷰라서 패키지 이름을 포함한 전체 이름으로 씁니다.
- `etTrim` 은 음수를 입력해야 하므로 `numberDecimal|numberSigned` 입니다. 나머지 게인은 0 이상이라 `numberDecimal` 만 씁니다.
- 앱 제목은 `NoActionBar` 테마라서 상단 바 대신 TextView 로 직접 보여 줍니다.

문자열과 테마 파일입니다.

<!-- include: part07_app/app/src/main/res/values/strings.xml -->

<!-- include: part07_app/app/src/main/res/values/themes.xml -->

`%1$s`, `%1$d` 는 Java 에서 `getString(R.string.tele_angle, "-1.25")` 처럼 값을 끼워 넣는 자리입니다. `$s` 는 문자열, `$d` 는 정수입니다.

## 7-06 블루투스 권한과 페어링

### 버전별 권한

블루투스 권한은 Android 12(API 31)에서 크게 바뀌었습니다.

| Android 버전 | 필요한 권한 | 허용 방식 |
|---|---|---|
| 11 이하 (API 30 이하) | `BLUETOOTH`, `BLUETOOTH_ADMIN` | 설치할 때 자동 허용 (일반 권한) |
| 12 이상 (API 31 이상) | `BLUETOOTH_CONNECT` (페어링 목록, 연결) | 실행 중 사용자에게 묻는 런타임 권한, "근처 기기" 그룹 |
| 12 이상 (API 31 이상) | `BLUETOOTH_SCAN` (주변 기기 검색) | 런타임 권한, `neverForLocation` 으로 위치 권한 없이 사용 |

이 앱은 이미 페어링된 기기에만 연결하므로 꼭 필요한 것은 `BLUETOOTH_CONNECT` 입니다. 연결 직전에 기기 검색을 멈추는 `cancelDiscovery()` 가 `BLUETOOTH_SCAN` 을 요구하기 때문에 SCAN 도 함께 선언하고 요청합니다. 두 권한은 같은 "근처 기기" 그룹이라 사용자에게는 대화상자가 한 번만 뜹니다.

매니페스트입니다.

<!-- include: part07_app/app/src/main/AndroidManifest.xml -->

- `android:maxSdkVersion="30"` 은 "API 30 까지만 이 권한을 요청한다"는 뜻입니다. API 31 이상에서는 새 권한만 씁니다.
- `android:usesPermissionFlags="neverForLocation"` 은 검색 결과로 사용자 위치를 추정하지 않겠다는 약속입니다. 이 선언이 있어야 API 31 이상에서 위치 권한 없이 검색 권한을 쓸 수 있습니다. `tools:targetApi="s"` 는 이 속성이 API 31 부터 있다는 Android Studio 경고를 끕니다.
- Activity 의 `android:exported="true"` 는 Android 12 부터 intent-filter 가 있는 Activity 에 반드시 적어야 합니다. 빠지면 설치 자체가 실패합니다.
- 아이콘은 템플릿 아이콘 파일이 없어도 빌드되도록 Android 기본 블루투스 아이콘(`@android:drawable/stat_sys_data_bluetooth`)을 씁니다. 템플릿의 `@mipmap/ic_launcher` 로 바꿔도 됩니다.

### 연결 흐름

[연결] 버튼을 누르면 `MainActivity.startConnectFlow()` 가 다음 순서로 진행합니다.

| 단계 | 확인 | 아니면 |
|---|---|---|
| 1 | 블루투스 하드웨어가 있는가 (`isSupported`) | Toast 후 종료 |
| 2 | API 31 이상이면 `BLUETOOTH_CONNECT` 가 허용되었는가 | `RequestMultiplePermissions` 로 요청, 거부되면 Toast |
| 3 | 블루투스가 켜져 있는가 | `ACTION_REQUEST_ENABLE` 로 켜기 요청 |
| 4 | 페어링된 기기가 있는가 | "먼저 페어링하세요" 안내 다이얼로그 |
| 5 | 목록 다이얼로그에서 기기 선택 | 취소 |
| 6 | `BluetoothService.connect()` | 실패 시 Toast |

권한 요청과 블루투스 켜기 요청은 `registerForActivityResult()` 로 등록한 런처를 씁니다. 예전 방식인 `onRequestPermissionsResult()`, `startActivityForResult()` 는 더 이상 권장되지 않습니다.

### 페어링은 앱이 아니라 휴대폰 설정에서

앱 안에서 검색하고 페어링까지 하도록 만들 수도 있지만 코드가 크게 늘어납니다. 이 과정은 휴대폰 설정, 블루투스 메뉴에서 HC-05 를 한 번 페어링(PIN 1234)해 두고, 앱은 페어링 목록에서 고르기만 합니다. 자세한 순서는 7-12 에 있습니다.

## 7-07 BluetoothService (연결, 송신, 수신 스레드)

<!-- include: part07_app/app/src/main/java/com/example/balancebot/BluetoothService.java -->

### SPP UUID

HC-05 는 블루투스 클래식의 SPP 를 지원합니다. SPP 의 표준 UUID 는 `00001101-0000-1000-8000-00805F9B34FB` 이고, `createRfcommSocketToServiceRecord(SPP_UUID)` 로 소켓을 만들면 HC-05 와 가상 시리얼 포트가 열립니다. 이후로는 `InputStream`, `OutputStream` 으로 UART 처럼 바이트를 주고받습니다.

### 왜 스레드가 필요한가

Android 는 메인(UI) 스레드에서 오래 걸리는 일을 하면 화면이 멈추고, 5초 이상이면 "응답 없음(ANR)" 창을 띄웁니다. 블루투스에는 오래 걸리는 호출이 두 가지 있습니다.

| 호출 | 걸리는 시간 | 처리 위치 |
|---|---|---|
| `socket.connect()` | 성공하면 1~2초, 실패하면 약 12초 | 작업 스레드 `bt-worker` |
| `inputStream.read()` | 데이터가 올 때까지 무한정 블록 | 같은 작업 스레드 (연결 후 수신 루프) |
| `outputStream.write()` | 보통 짧지만 버퍼가 차면 블록 | 단일 스레드 Executor (송신 순서 보장) |

반대로 화면 위젯은 메인 스레드에서만 만질 수 있습니다. 그래서 작업 스레드는 결과를 직접 화면에 쓰지 않고 `Handler(Looper.getMainLooper()).post(...)` 로 메인 스레드에 넘깁니다. `Listener` 의 세 메서드(`onStateChanged`, `onLineReceived`, `onError`)는 항상 메인 스레드에서 불리므로 MainActivity 는 바로 `setText()` 해도 안전합니다.

### 수신: 바이트를 줄로 모으기

블루투스는 한 프레임이 한 번에 오지 않습니다. `#A,-125,40,7600,3*..\n` 이 `#A,-12` 와 `5,40,7600,3*..\n` 처럼 쪼개져 오거나, 두 프레임이 한 번에 붙어서 오기도 합니다. 그래서 `Protocol.LineAssembler` 가 `\n` 이 나올 때까지 버퍼에 모았다가 한 줄씩 넘겨 줍니다. `\r` 은 SPEC 대로 무시하고, 48바이트를 넘는 줄은 버립니다. 완성된 줄은 `Protocol.tryParse()` 로 파싱하고, 체크섬이나 형식이 틀리면 `null` 이 되어 MainActivity 가 무시합니다.

### 연결 끊김 처리

HC-05 전원이 꺼지거나 거리가 멀어지면 `read()` 가 `IOException` 을 던지고 수신 루프가 끝납니다. 이때 "블루투스 연결이 끊어졌습니다" 오류와 `DISCONNECTED` 상태를 메인 스레드로 보냅니다. MainActivity 는 이를 받아 조이스틱 타이머를 멈추고, 모터 스위치를 끄고, 버튼을 비활성화합니다.

사용자가 [끊기]를 누르면 `disconnect()` 가 소켓을 닫습니다. 소켓을 닫으면 블록되어 있던 `read()` 나 `connect()` 가 예외로 깨어나는데, 이때는 `worker` 필드가 이미 `null` 이라서 "내가 지금 작업 스레드가 아니구나" 를 알고 오류 메시지 없이 조용히 끝납니다. 닫기 작업도 송신 Executor 에 넣기 때문에 직전에 보낸 `$D,0,0` 이 먼저 전송된 뒤 소켓이 닫힙니다.

## 7-08 프로토콜 클래스와 체크섬

SPEC 4장의 프로토콜을 한 번 더 정리합니다.

```
앱 -> 로봇 : $<TYPE>[,<필드>...]*<HH>\n
로봇 -> 앱 : #<TYPE>[,<필드>...]*<HH>\n
```

- HH 는 시작 문자(`$` 또는 `#`) 다음부터 `*` 직전까지 모든 바이트의 XOR, 대문자 16진수 2자리입니다.
- 필드는 10진 정수만 씁니다. 실수는 100배 정수로 보냅니다 (Kp 25.00 은 2500).
- 프레임 최대 길이는 48바이트이고 `\r` 은 무시합니다.

체크섬을 손으로 계산해 보면 다음과 같습니다.

| 프레임 본문 | 바이트 | XOR | 완성 프레임 |
|---|---|---|---|
| `G` | 0x47 | 0x47 | `$G*47` |
| `M,1` | 0x4D, 0x2C, 0x31 | 0x4D ^ 0x2C = 0x61, 0x61 ^ 0x31 = 0x50 | `$M,1*50` |
| `E,4` | 0x45, 0x2C, 0x34 | 0x45 ^ 0x2C = 0x69, 0x69 ^ 0x34 = 0x5D | `#E,4*5D` |

`Protocol.java` 는 Android 클래스를 하나도 import 하지 않습니다. 그래서 같은 파일을 앱에도 쓰고, PC 의 javac 로 테스트도 합니다.

<!-- include: part07_app/app/src/main/java/com/example/balancebot/Protocol.java -->

주요 메서드는 다음과 같습니다.

| 메서드 | 하는 일 |
|---|---|
| `checksum(body)` | 본문 XOR 계산 |
| `drive`, `pid`, `trim`, `speedGain`, `motor`, `save`, `get` | 앱 -> 로봇 프레임 생성 (끝에 `\n` 포함). 범위를 벗어난 게인은 예외, 조이스틱은 -100..100 으로 자름 |
| `telemetry`, `params`, `ok`, `error` | 로봇 -> 앱 프레임 생성 (테스트용) |
| `parse(line)` | 한 줄을 `Message` 객체로. 체크섬이 틀리면 `ProtocolException(CHECKSUM)` |
| `tryParse(line)` | 실패하면 `null` 을 돌려주는 간편판 |
| `LineAssembler.feed()` | 조각난 바이트를 줄 단위로 모음 |
| `parseX100("1.25")`, `formatX100(125)` | 입력칸 문자열과 x100 정수 사이 변환 |
| `stateName(3)` | 상태 번호를 이름("BALANCE")으로 |

`parseX100()` 은 `double` 을 쓰지 않고 `BigDecimal` 로 변환합니다. `Double.parseDouble("0.29") * 100` 은 28.999999999999996 이 되어 정수로 자르면 28 이 되는 문제가 있기 때문입니다.

### PC 에서 테스트하기

<!-- include: part07_app/test/ProtocolTest.java -->

`part07_app` 폴더에서 다음 명령으로 컴파일하고 실행합니다.

```
javac -encoding UTF-8 -d build/test app/src/main/java/com/example/balancebot/Protocol.java test/ProtocolTest.java
java -cp build/test ProtocolTest
```

모두 통과하면 다음처럼 출력됩니다.

```
ProtocolTest: 모든 검사 통과 (93개)
```

테스트는 SPEC 의 예시 `$G*47`, `$M,1*50` 을 글자 그대로 확인하고, `#A,-125,40,7600,3` 프레임을 만든 뒤 다시 파싱해 값이 같은지(왕복), 체크섬 한 자리만 틀려도 거부하는지, 쪼개져 들어온 바이트를 줄로 바르게 모으는지 검사합니다. Java 의 `assert` 문은 `-ea` 옵션 없이는 꺼져 있으므로 쓰지 않고, 직접 비교해서 틀리면 예외를 던집니다.

## 7-09 조이스틱 커스텀 뷰

GitHub 에는 조이스틱 오픈소스 라이브러리가 여럿 있고, Gradle 의존성 한 줄로 가져다 쓸 수도 있습니다. 빠르게 만들 때는 좋은 선택이지만, 라이브러리마다 좌표 범위와 축 방향이 달라 SPEC 의 "-100..100, y 는 위가 +" 에 맞추는 변환을 따로 해야 하고, 저장소가 관리되지 않으면 새 Android 버전에서 빌드가 깨질 수 있습니다. 이 과정은 외부 라이브러리 없이 `View` 를 상속해 직접 만듭니다. 커스텀 뷰의 기본(`onMeasure`, `onDraw`, `onTouchEvent`)을 한 번에 익힐 수 있는 좋은 예제이기도 합니다.

<!-- include: part07_app/app/src/main/java/com/example/balancebot/JoystickView.java -->

### 좌표 변환

| 단계 | 식 | 설명 |
|---|---|---|
| 1 | `dx = touchX - centerX`, `dy = touchY - centerY` | 가운데 기준 손가락 위치 (픽셀) |
| 2 | 거리 `> baseRadius` 이면 `dx, dy` 에 `baseRadius / 거리` 곱하기 | 원 밖으로 나가면 둘레에 붙임 |
| 3 | `x = dx / baseRadius * 100` | 오른쪽 끝 +100, 왼쪽 끝 -100 |
| 4 | `y = -dy / baseRadius * 100` | 화면 좌표는 아래가 + 라서 부호를 뒤집어 위쪽 끝이 +100 |

손잡이가 끝까지 가도 뷰 밖으로 삐져나가지 않도록 `baseRadius = 뷰 반지름 - 손잡이 반지름` 으로 잡았습니다.

### 50 ms 주기 전송

조이스틱 뷰는 값만 알려 주고, 전송 주기는 MainActivity 가 `Handler.postDelayed()` 로 관리합니다.

| 이벤트 | MainActivity 동작 |
|---|---|
| `onJoystickStart()` (손가락 닿음) | `joyTask` 를 바로 실행, 이후 50 ms 마다 반복하며 `$D,x,y` 전송 |
| `onJoystickMove(x, y)` | 화면의 `x 0, y 0` 표시만 갱신 (전송은 타이머가 함) |
| `onJoystickRelease()` (손 뗌) | 타이머 정지 후 `$D,0,0` 한 번 전송 |

움직일 때마다 보내지 않고 타이머로 보내는 이유는 두 가지입니다. 터치 이벤트는 1초에 60~120번 들어와 9600 bps 링크를 넘칠 수 있고, 손가락을 한 곳에 가만히 두면 이벤트가 오지 않아 로봇의 500 ms 타임아웃에 걸려 멈추기 때문입니다. 50 ms 주기면 가장 긴 `$D,-100,-100*HH\n` (16바이트) 기준으로 초당 320바이트, 9600 bps(초당 약 960바이트)의 약 33% 입니다.

조이스틱은 ScrollView 안에 있어서 위아래로 드래그하면 ScrollView 가 터치를 가로채 화면이 스크롤됩니다. `ACTION_DOWN` 에서 `getParent().requestDisallowInterceptTouchEvent(true)` 를 불러 이를 막습니다.

## 7-10 PID 튜닝 UI

MainActivity 의 전체 코드입니다. PID 튜닝, 텔레메트리, 연결 흐름이 모두 여기에 있습니다.

<!-- include: part07_app/app/src/main/java/com/example/balancebot/MainActivity.java -->

### 입력과 변환

입력칸 5개는 사람이 읽기 쉬운 소수로 받고, 보낼 때 x100 정수로 바꿉니다.

| 입력칸 | 예 | 보내는 값 | 프레임 | 허용 범위 (입력값) |
|---|---|---|---|---|
| Kp | 25.00 | 2500 | `$P,kp,ki,kd` | 0.00 ~ 1000.00 |
| Ki | 0.10 | 10 | (같은 `$P`) | 0.00 ~ 1000.00 |
| Kd | 0.80 | 80 | (같은 `$P`) | 0.00 ~ 1000.00 |
| Trim | -1.50 | -150 | `$T,trim` | -10.00 ~ 10.00 |
| Ks | 12.00 | 1200 | `$V,ks` | 0.00 ~ 1000.00 |

소수 셋째 자리까지 입력하거나 범위를 벗어나면 그 칸에 `setError()` 로 빨간 오류 표시를 하고 아무것도 보내지 않습니다. 일부 키보드는 소수점으로 쉼표를 넣기 때문에 `1,25` 도 1.25 로 받아 줍니다.

### 버튼 동작

| 버튼 | 보내는 프레임 | 로봇 응답 | 앱 동작 |
|---|---|---|---|
| [보내기] | `$P`, `$T`, `$V` 순서로 3개 | 각각 `#K` | 마지막 `#K` 로 입력칸 갱신 |
| [읽기] | `$G` | `#K` | 입력칸 갱신 |
| [저장] | `$S` | `#K` 와 `#O,S` | 입력칸 갱신, "EEPROM 에 저장했습니다" Toast |
| (연결 직후 자동) | `$G` | `#K` | 입력칸 갱신 |

`#K` 를 받으면 입력칸을 로봇이 실제로 가진 값으로 덮어씁니다. 그래서 [보내기] 후 입력칸 값이 바뀌지 않으면 로봇이 값을 잘 받은 것이고, 이상한 값으로 바뀌면 로봇 쪽 처리를 의심할 수 있습니다. 로봇이 범위 오류(`#E,3`)를 보내면 Toast 로 "로봇 오류 3: 범위" 가 뜹니다.

[저장]을 누르기 전까지는 로봇 전원을 끄면 값이 사라집니다. 튜닝은 [보내기]로 여러 번 시험하고, 마음에 드는 값을 찾았을 때 [저장]을 누르는 흐름입니다.

### 모터 허용 스위치

스위치를 켜면 `$M,1`, 끄면 `$M,0` 을 보냅니다. 연결이 끊기면 스위치를 자동으로 끕니다. 코드에서 스위치를 끌 때 리스너가 다시 `$M,0` 을 보내지 않도록 `ignoreSwitchEvent` 플래그를 씁니다 (`setMotorSwitchSilently()`).

## 7-11 텔레메트리 표시

로봇은 10 Hz 로 `#A,angle,out,mv,st` 를 보냅니다. `showTelemetry()` 가 이를 다음처럼 바꿔 표시합니다.

| 필드 | 수신 예 | 변환 | 표시 |
|---|---|---|---|
| angle (각도 x100) | -125 | `formatX100(-125)` | 각도: -1.25 도 |
| out (모터 출력) | 40 | 그대로 | 출력: 40 |
| mv (배터리 mV) | 7600 | `formatX100(7600 / 10)` | 배터리: 7.60 V |
| st (상태 번호) | 3 | `stateName(3)` | 상태: 3 BALANCE |

상태 번호는 SPEC 의 표를 그대로 따릅니다.

| 번호 | 이름 | 의미 |
|---|---|---|
| 0 | INIT | 초기화 |
| 1 | CALIB | 자이로 보정 중 (로봇을 가만히 두세요) |
| 2 | WAIT_UPRIGHT | 세워 주기를 기다림 |
| 3 | BALANCE | 균형 제어 중 |
| 4 | FALLEN | 넘어짐 |
| 5 | IDLE | 모터 정지 명령 (`$M,0`) 상태 |
| 6 | LOW_BATT | 배터리 부족 |

오류 `#E,n` 은 화면 대신 Toast 로 잠깐 보여 줍니다 (1 체크섬, 2 형식, 3 범위, 4 알 수 없는 명령).

화면 맨 아래 "수신 확인" 구역은 디버그용입니다. 마지막으로 받은 줄을 그대로 보여 주고, 정상 줄과 무시한 줄(체크섬이나 형식 오류)의 개수를 셉니다. 무시 개수가 계속 늘면 통신 품질이나 로봇 쪽 체크섬 계산을 의심합니다.

## 7-12 휴대폰에 설치하고 HC-05 와 테스트하기

### 1. 개발자 옵션과 USB 디버깅 켜기

1. 휴대폰 설정, 휴대전화 정보(삼성은 설정, 휴대전화 정보, 소프트웨어 정보)에서 **빌드번호**를 7번 연속 누릅니다. "개발자 모드를 켰습니다" 가 뜹니다.
2. 설정 맨 아래(또는 시스템 안)에 생긴 **개발자 옵션**에 들어가 **USB 디버깅**을 켭니다.
3. USB 케이블로 PC 에 연결합니다. 휴대폰에 "USB 디버깅을 허용하시겠습니까?" 가 뜨면 "이 컴퓨터에서 항상 허용" 을 체크하고 허용합니다. 충전 전용 케이블이면 인식되지 않으니 데이터 케이블을 씁니다.
4. Windows 에서 기기가 안 보이면 휴대폰 제조사의 USB 드라이버(삼성은 Samsung Android USB Driver)를 설치합니다.

### 2. 앱 설치 (Run)

1. Android Studio 위쪽 도구 막대의 기기 목록에 휴대폰 모델명이 보이는지 확인합니다.
2. 초록색 Run 버튼(삼각형, 단축키 Shift+F10)을 누릅니다. 빌드가 끝나면 휴대폰에 앱이 설치되고 바로 실행됩니다.
3. 이후 코드를 고칠 때마다 Run 을 다시 누르면 됩니다.

### 3. HC-05 페어링

1. 로봇 전원을 켭니다. HC-05 의 LED 가 빠르게 깜빡이면(약 1초에 2번 이상) 연결 대기 상태입니다.
2. 휴대폰 설정, 연결, 블루투스에서 검색하면 `HC-05` 가 보입니다. 누르고 PIN 으로 **1234** 를 입력합니다. (일부 모듈은 0000 입니다.)
3. "등록된 기기" 목록에 HC-05 가 생기면 페어링 완료입니다. 페어링은 한 번만 하면 됩니다.

### 4. 앱만으로 확인하는 순서

PC 시리얼 터미널 없이 앱 화면만으로 통신과 펌웨어를 차례로 확인합니다. 위 단계가 통과해야 다음 단계로 갑니다. 첫 시험은 로봇 바퀴가 바닥에 닿지 않도록 손에 들거나 받침대에 올려 두고 합니다.

| 단계 | 할 일 | 정상 결과 | 확인하는 것 |
|---|---|---|---|
| 1 | 앱 실행, [연결] | Android 12 이상은 "근처 기기" 권한 요청이 뜸, 허용 | 권한 선언 |
| 2 | 목록에서 HC-05 선택 | "연결 중: HC-05" 다음 "연결됨: HC-05", HC-05 LED 가 2초에 한 번 두 번씩 깜빡임 | SPP 연결 |
| 3 | 화면 아래 "수신 확인" 보기 | `#A,...` 줄이 계속 바뀌고 "정상" 개수가 1초에 약 10씩 늘어남, "무시" 는 0 | 로봇 -> 앱 수신, 체크섬 |
| 4 | 로봇을 앞뒤로 기울임 | 각도가 부호를 바꾸며 변함, 똑바로 세우면 0 근처 | IMU, 텔레메트리 파싱 |
| 5 | 배터리 값 보기 | 7.0 ~ 8.4 V 사이 | ADC, 분압 |
| 6 | 상태 보기 | 보정 후 2 WAIT_UPRIGHT 또는 3 BALANCE | 상태 번호표 |
| 7 | 입력칸 확인 | 연결 직후 자동으로 숫자가 채워짐 | 앱 -> 로봇 송신 (`$G`), `#K` 파싱 |
| 8 | Kp 를 바꾸고 [보내기] | 입력칸이 바꾼 값 그대로 유지됨 (로봇이 `#K` 로 되돌려 줌) | `$P`,`$T`,`$V` |
| 9 | 앱을 껐다 켜서 다시 연결 | 바꾼 Kp 가 아니라 이전 값이 보임 (아직 저장 안 함) | RAM 과 EEPROM 구분 |
| 10 | 다시 바꾸고 [저장], 로봇 재부팅 후 연결 | "EEPROM 에 저장했습니다" Toast, 재부팅 후에도 바꾼 값 | `$S`, `#O,S` |
| 11 | 모터 허용 끄기 | 상태가 5 IDLE | `$M,0` |
| 12 | 모터 허용 켜기 | 상태가 2 또는 3 | `$M,1` |
| 13 | 조이스틱을 위로 밀고 있기 | 화면에 y 가 + 값, 모터 출력이 변함 | `$D` 50 ms 주기 |
| 14 | 손 떼기 | x 0, y 0, 로봇이 제자리 균형 | `$D,0,0` |
| 15 | 로봇 전원 끄기 | "블루투스 연결이 끊어졌습니다" Toast, "연결 안 됨" | 끊김 처리 |

3단계에서 "무시" 만 늘어나면 로봇 쪽 체크섬이나 줄끝 문자를 의심하고, 아무 줄도 오지 않으면 HC-05 의 TX, RX 배선과 보레이트(9600)를 의심합니다.

## 7-13 문제 해결 체크리스트 (앱 코드 관점)

### 빌드와 설치

| 증상 | 원인과 확인 |
|---|---|
| `cannot find symbol R.id.xxx` | 레이아웃의 `@+id` 와 Java 의 `R.id` 철자가 다름. 대소문자까지 같은지 확인. 레이아웃 파일을 덮어썼는지 확인 |
| `cannot find symbol R.string.xxx` | strings.xml 을 덮어쓰지 않았거나 이름이 다름 |
| `package com.example.balancebot does not exist` 또는 R 을 못 찾음 | 새 프로젝트의 패키지 이름이 다름. `app/build.gradle` 의 `namespace` 가 `com.example.balancebot` 인지 확인 |
| `resource style/Theme.BalanceBot not found` | 프로젝트 Name 이 BalanceBot 이 아니었거나 themes.xml 을 덮어쓰지 않음 |
| `Theme.MaterialComponents` 를 못 찾음 | 의존성에 `com.google.android.material:material` 이 없음 |
| `Manifest.permission.BLUETOOTH_CONNECT` 를 못 찾음 | compileSdk 가 31 미만. 34 로 올림 |
| `Lambda expressions are not supported` | compileOptions 가 Java 8 미만. Java 8 이상으로 설정 |
| 설치 실패 `INSTALL_PARSE_FAILED_MANIFEST_MALFORMED` | Activity 에 `android:exported="true"` 가 빠짐 |
| 기기 목록에 휴대폰이 안 보임 | USB 디버깅, 데이터 케이블, 드라이버, "USB 디버깅 허용" 팝업 확인 |

### 실행 중

| 증상 | 원인과 확인 |
|---|---|
| 앱이 켜지자마자 죽음 (`ClassCastException`) | 레이아웃의 위젯 종류와 Java 의 타입이 다름. 예: XML 은 `Switch`, Java 는 `SwitchCompat` |
| 앱이 켜지자마자 죽음 (`Error inflating class com.example.balancebot.JoystickView`) | JoystickView.java 를 복사하지 않았거나 패키지 선언이 다름. 생성자 `(Context, AttributeSet)` 가 있어야 XML 에서 만들 수 있음 |
| `You need to use a Theme.AppCompat theme` | 매니페스트의 `android:theme` 가 우리 테마가 아님 |
| [연결]을 눌러도 아무 반응 없음 (Android 12 이상) | 권한 대화상자에서 "허용 안 함" 을 눌렀음. 설정, 애플리케이션, BalanceBot, 권한에서 "근처 기기" 허용 |
| `SecurityException: Need android.permission.BLUETOOTH_CONNECT` | 매니페스트에 `BLUETOOTH_CONNECT` 선언 누락, 또는 권한 확인 전에 블루투스 API 호출 |
| 페어링 목록이 비어 있음 | 휴대폰 설정에서 HC-05 를 먼저 페어링 (PIN 1234) |
| "HC-05 에 연결하지 못했습니다" | 로봇 전원, 다른 휴대폰이나 PC 가 이미 연결 중인지, 거리. 블루투스를 껐다 켜고 재시도. 계속 실패하면 페어링 해제 후 다시 페어링 |
| 화면이 멈추거나 ANR | 메인 스레드에서 `connect()` 나 `read()` 를 부르고 있음. BluetoothService 의 작업 스레드를 거치는지 확인 |
| `CalledFromWrongThreadException` | 작업 스레드에서 직접 `setText()` 를 부름. `Handler.post()` 또는 `runOnUiThread()` 로 넘김 |

### 통신

| 증상 | 원인과 확인 |
|---|---|
| 연결됐는데 텔레메트리가 안 바뀜, "정상" 0 | 로봇이 보내지 않음 (펌웨어, HC-05 TX 배선, 9600 bps). "수신 확인" 에 아무 줄도 없는지 봄 |
| "무시" 개수만 늘어남 | 체크섬 불일치. 로봇이 소문자 16진수를 쓰거나, XOR 범위에 `#` 나 `*` 를 넣었거나, 줄끝이 `\n` 이 아님 |
| 로봇이 `#E,1` (체크섬) 을 계속 보냄 | 앱 프레임 체크섬 문제. `ProtocolTest` 를 다시 돌려 확인. 로봇 쪽 XOR 범위도 확인 |
| 로봇이 `#E,3` (범위) 을 보냄 | 입력값이 SPEC 범위를 벗어남 (Trim 은 -10.00 ~ 10.00) |
| 조이스틱을 누르고 있는데 로봇이 0.5초 뒤 멈춤 | 50 ms 타이머가 돌지 않음. `onJoystickStart()` 에서 `handler.post(joyTask)` 가 불리는지, 연결 상태인지 확인 |
| 조이스틱 위로 밀었는데 로봇이 뒤로 감 | 앱은 위가 +y 로 맞음. 로봇 쪽 모터 방향 매크로(MOTOR_L_INVERT, MOTOR_R_INVERT)나 각도 부호 확인 |
| 조이스틱을 위아래로 움직이면 화면이 스크롤됨 | `requestDisallowInterceptTouchEvent(true)` 호출 누락 |
| 손을 뗐는데 로봇이 계속 움직임 | `onJoystickRelease()` 에서 `$D,0,0` 을 보내는지 확인. 로봇의 500 ms 타임아웃 동작도 확인 |
| [보내기] 후 입력칸이 이전 값으로 돌아감 | 로봇이 값을 거부했거나 `#K` 가 이전 값을 보고함. Toast 에 `#E` 가 떴는지 확인 |

문제가 앱 쪽인지 로봇 쪽인지 헷갈리면, 먼저 `ProtocolTest` 로 앱의 프로토콜 코드가 맞는지 확인하고, 다음으로 "수신 확인" 구역에서 로봇이 보낸 원래 줄을 그대로 읽어 봅니다. 화면에 보이는 줄의 체크섬을 7-08 의 표처럼 손으로 계산해 보면 어느 쪽이 틀렸는지 바로 알 수 있습니다.
