hjunhuh/balancebot-course/part06_mech/stl/plate_middle.stl

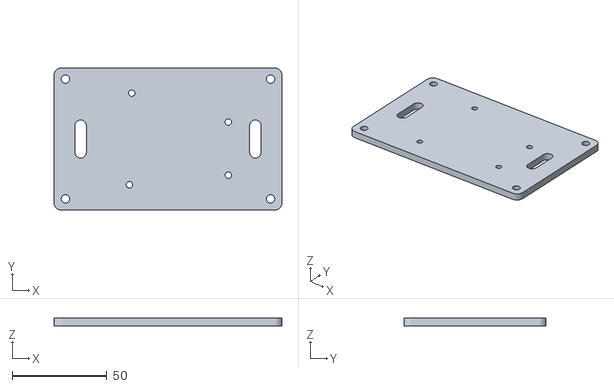
[picture p6: CAD file, 2026-11-02]
part06_mech/stl/plate_middle.stl
120.0 x 75.0 x 4.00
