hjunhuh/balancebot-course/part06_mech/stl/motor_bracket.stl

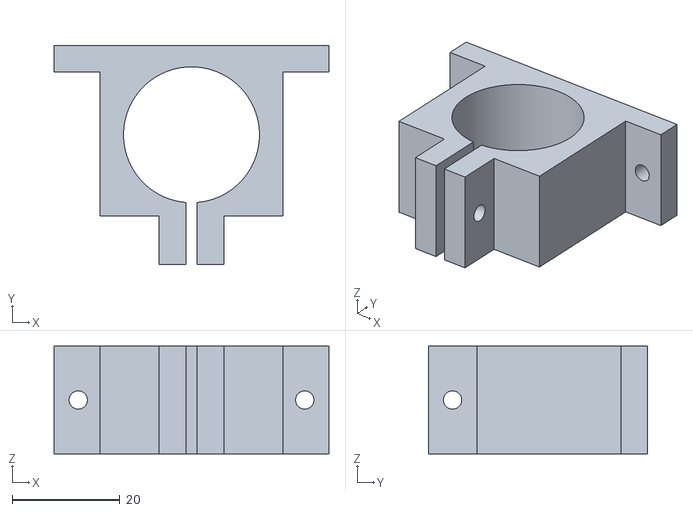
[picture p7: CAD file, 2026-11-02]
part06_mech/stl/motor_bracket.stl
51.0 x 40.7 x 20.0
