hjunhuh/balancebot-course/(list of files, cad)

Other CAD files:
part06_mech/stl/plate_top.stl
part06_mech/stl/plate_bottom.stl
part06_mech/dxf/plate_bottom.dxf
part06_mech/dxf/plate_middle.dxf
part06_mech/dxf/plate_top.dxf
