hjunhuh/balancebot-course/part09_test/README.md

# Part 9. 밸런싱로봇 통합 TEST

V 모델의 오른쪽을 올라가는 단계입니다. HW, 펌웨어, 앱을 한꺼번에 붙이면 문제가 생겼을 때 원인이 어디인지 알 수 없습니다. 작은 단위부터 하나씩 붙이고, 각 단계마다 Part 4 요구사항을 판정 기준으로 씁니다.

## 9-01 통합 순서

| 단계 | 붙이는 것 | 확인할 것 | 테스트 |
|---|---|---|---|
| 1 | 쉴드 + Uno (모듈 없음) | 단락, 전압, 분압비 | 5-10 점검표 |
| 2 | + 펌웨어 | 부팅, LED, 텔레메트리 | TC-01, TC-02 |
| 3 | + MPU6050 | 각도 부호, 보정 | TC-03, TC-13 |
| 4 | + L298N, 모터 (바퀴 띄움) | 모터 방향, 데드존 | TC-04, TC-05, TC-08 |
| 5 | + HC-05, 앱 | 명령, 응답, 저장, 끊김 | TC-06, TC-07, TC-09, TC-14 |
| 6 | + 배터리, 기구 완성 | 저전압 | TC-10 |
| 7 | 바닥에 세움 | 밸런싱, 조종 | 9-04 튜닝 후 TC-11, TC-12 |

## 9-02 준비물

- 휴대폰에 "Serial Bluetooth Terminal" 류의 시리얼 터미널 앱 (Part 7 앱 이전 단계 확인용)
- 멀티미터
- 바퀴를 띄울 받침 (책, 상자)
- 넘어질 때 받을 손 또는 부드러운 매트
- 결과 기록용 표 (9-07 템플릿)

체크섬 계산이 번거로우면 아래 프레임을 그대로 복사해 보냅니다. 터미널 앱의 줄 끝 설정은 LF(`\n`) 로 둡니다.

| 목적 | 프레임 |
|---|---|
| 파라미터 요청 | `$G*47` |
| 모터 허용 | `$M,1*50` |
| 모터 정지 | `$M,0*51` |
| 저장 | `$S*53` |
| 조이스틱 중립 | `$D,0,0*44` |

## 9-03 테스트 케이스 명세

| ID | 요구사항 | 절차 | 기대 결과 |
|---|---|---|---|
| TC-01 | SYS-08, SWR-03 | 바퀴를 띄우고 로봇을 가만히 둔 채 전원 투입 | LED 가 약 1 초 빠르게 깜빡인 뒤 1 Hz 깜빡임 (WAIT_UPRIGHT). 보정 중 흔들면 빠른 깜빡임이 다시 1 초 이어짐 |
| TC-02 | SWR-01, SWR-08 | 터미널로 수신, 10 초간 줄 수 세기 | `#A,...` 줄이 약 100 개, 마지막 필드(상태)가 2 |
| TC-03 | SWR-02 | 로봇을 손으로 앞으로 약 20 도, 뒤로 약 20 도 기울임 | `#A` 각도 필드가 앞 약 +2000, 뒤 약 -2000. 반대면 `IMU_ANGLE_SIGN` 수정 |
| TC-04 | SYS-03 | 바퀴 띄우고 손으로 세워 WAIT 통과(LED 켜짐) 후 앞으로 살짝 기울임 | 두 바퀴 모두 로봇 앞쪽으로 회전. 반대인 쪽은 `MOTOR_x_INVERT` 수정 |
| TC-05 | SWR-04 | TC-04 상태에서 아주 조금씩 기울이며 바퀴가 돌기 시작하는 순간의 `#A` 출력 필드 관찰 | 출력 약 10 이내에서 바퀴가 돌기 시작. 너무 늦으면 `MOTOR_DEADBAND_PWM` 올림, 출력 0 근처에서 윙윙거리면 내림 |
| TC-06 | SWR-05 | `$G*47`, `$G*48`, `$Q*51`, `$P,-1,0,0*60` 전송 | 각각 `#K,...`, `#E,1`, `#E,4`, `#E,3` 수신 |
| TC-07 | SYS-05, SWR-06, 07 | `$P,3000,100,90*..` (앱 사용 권장) 후 `$S*53`, 전원 껐다 켬, `$G*47` | `#O,S` 와 `#K` 수신, 재부팅 후 `#K,3000,100,90,...` 유지. 저장 중에도 밸런싱이 끊기지 않음 |
| TC-08 | SYS-06 | 밸런싱 중(또는 바퀴 띄우고 BALANCE 상태) 로봇을 45 도 이상 기울임 | 즉시 모터 정지, 상태 4, LED 1 Hz. 다시 세우면 0.3 초 뒤 재개 |
| TC-09 | SYS-04 | 앱 조이스틱을 앞으로 민 상태에서 블루투스 연결을 강제로 끊음(앱 종료) | 0.5 초 이내 전진이 멈추고 제자리 밸런싱 |
| TC-10 | SYS-07 | 가변 전원 장치로 VIN 을 7.0 V 에서 6.4 V 로 낮춤 (가변 전원이 없으면 방전된 배터리 사용) | 6.6 V 아래로 2 초 지나면 상태 6, 모터 정지, LED 두 번 깜빡임 반복 |
| TC-11 | SYS-01, 02 | 평탄한 바닥에서 세우고 손을 뗌, 60 초 관찰 | 60 초 이상 서 있음, `#A` 각도 필드 ±200 (±2 도) 이내 |
| TC-12 | SYS-03 | 앱 조이스틱 전진, 후진, 좌회전, 우회전 각 3 초 | 해당 방향으로 움직이고 넘어지지 않음 |
| TC-13 | SYS-08, 09, SWR-10 | 동작 중 MPU6050 SDA 선을 뽑았다 다시 꽂음 | 뽑는 즉시 모터 정지, LED 100 ms 토글. 다시 꽂으면 1 초 안에 재보정 시작 |
| TC-14 | SYS-08 | 버튼을 한 번 누름, 다시 누름 | 첫 번째: 상태 5 (IDLE), 모터 정지, LED 꺼짐. 두 번째: 상태 2 로 복귀 |

TC-06 의 잘못된 프레임 체크섬은 의도한 값입니다. `$Q*51` 은 Q(0x51) 로 체크섬은 맞고 명령이 없으므로 `#E,4`, `$P,-1,0,0*60` 은 체크섬이 맞고 값이 범위 밖이라 `#E,3` 입니다.

## 9-04 PID 튜닝 절차 (실제 로봇)

먼저 기본값(Kp 15, Ki 100, Kd 0.25, Ks 5)으로 세워 봅니다. Part 8 시뮬레이터에서 27 가지 로봇 조건 중 21 가지를 통과한 값이라 좋은 출발점입니다. 서지 못하면 아래 순서로 찾습니다. 한 번에 한 값만 바꾸고, 바꿀 때마다 앱 화면의 각도와 출력을 함께 봅니다.

1. **트림 맞추기**: 로봇을 손가락으로 가볍게 받쳐 스스로 균형이 잡히는 각도를 찾고, 그때의 `#A` 각도를 Trim 에 넣습니다. 배터리 위치가 조금만 치우쳐도 0 이 아닙니다.
2. **Kp**: Ki, Kd, Ks 를 0 으로 두고 Kp 를 20 부터 10 씩 올립니다. 손으로 살짝 밀었을 때 바퀴가 세게 받쳐 주는지 봅니다. 빠르게 떨기 시작하는 값을 찾고 그 값의 약 0.6 배로 둡니다. 이 단계에서는 혼자 서지 못하는 것이 정상입니다 (8-14 둘째 결정).
3. **Kd**: 0.5 부터 0.25 씩 올립니다. 떨림이 줄어들고 움직임이 부드러워집니다. 너무 크면 높은 소리로 윙윙거립니다.
4. **Ki**: 50 부터 50 씩 올립니다. 혼자 몇 초씩 서기 시작합니다. 대신 한쪽으로 점점 달려갑니다.
5. **Ks**: 5 부터 5 씩 올립니다. 달려가던 현상이 줄어 제자리에 머뭅니다. 너무 크면 느리게 크게 앞뒤로 출렁입니다.
6. **마무리**: Trim 을 0.1 도 단위로 조정해 한 방향으로 미끄러지는 현상을 없애고 `$S` 로 저장합니다.

| 값 | 너무 작음 | 너무 큼 |
|---|---|---|
| Kp | 힘없이 쓰러짐 | 빠른 진동 (초당 여러 번) |
| Kd | 떨림이 오래 감 | 고주파 윙윙 소리, 모터 발열 |
| Ki | 서지 못함, 한쪽으로 기운 채 쓰러짐 | 느린 큰 진동 |
| Ks | 한 방향으로 점점 빨라지다 넘어짐 | 앞뒤로 느리게 출렁임 |

튜닝 기록 예시 (포트폴리오에 그대로 씁니다)

| 회차 | Kp | Ki | Kd | Ks | Trim | 결과 |
|---|---|---|---|---|---|---|
| 1 | 15 | 100 | 0.25 | 5 | 0.0 | (예시) 2 초 후 앞으로 달려가 넘어짐 |
| 2 | 15 | 100 | 0.25 | 5 | -1.2 | (예시) 15 초 유지, 느리게 앞으로 이동 |
| 3 | 15 | 100 | 0.25 | 8 | -1.2 | (예시) 60 초 유지, 진폭 ±1.5 도 |

## 9-05 증상별 확인 포인트

| 증상 | 먼저 볼 것 | 관련 위치 |
|---|---|---|
| 세우자마자 한쪽으로 쓰러지고 바퀴가 반대로 돎 | TC-03 각도 부호, TC-04 모터 방향 | `config.h` `IMU_ANGLE_SIGN`, `MOTOR_x_INVERT` |
| 한쪽 바퀴만 반대로 돎 | 그 모터의 OUT 단자 두 선 | `MOTOR_L_INVERT` 또는 `MOTOR_R_INVERT` |
| 빠르게 떨며 윙윙거림 | Kp, Kd 과다, IMU 고정 상태, 볼트 풀림 | 앱 튜닝, 기구 |
| 느리게 크게 출렁임 | Ki, Ks 과다 | 앱 튜닝 |
| 점점 빨라지다 넘어짐 | Ks 부족, Trim | 앱 튜닝 |
| 잘 서 있다가 갑자기 모터가 멈춤 | `#A` 상태 필드: 6 이면 저전압, LED 100 ms 토글이면 IMU 통신, LED 빠른 깜빡임 후 1 Hz 면 리셋 후 재보정 | TC-10, TC-13, 전원 배선 |
| 모터를 세게 돌릴 때마다 리셋 | 배터리 전압이 순간적으로 7 V 아래로 떨어짐 | C1 벌크 커패시터, 배터리 충전 상태, 배선 굵기 |
| 계속 보정 상태 (빠른 깜빡임) | 보정 중 진동, 책상 흔들림 | `CALIB_STILL_DPS` |
| 앱은 연결되는데 반응 없음 | `#E,1` 이 오는지, 상태 5 인지 | 앱 체크섬, `$M,1` |
| 텔레메트리 글자가 깨짐 | HC-05 데이터 모드 보레이트 | Part 3 lab14 AT 명령 `AT+UART?` |
| 저전압이 아닌데 상태 6 | A0 전압, 분압 저항값 | `VBAT_DIV_RATIO`, R1, R2 |

## 9-06 시연 영상 체크리스트

포트폴리오와 면접에서 가장 강한 증거는 영상입니다.

- [ ] 전원 투입부터 보정, 세우기, 손 떼기까지 끊지 않고 한 번에 (30 초)
- [ ] 60 초 이상 서 있는 장면 (화면 구석에 타이머)
- [ ] 손가락으로 미는 외란에 복원하는 장면
- [ ] 앱으로 전후진, 회전 조종 (휴대폰 화면 함께)
- [ ] 넘어뜨렸을 때 바퀴가 멈추는 안전 동작
- [ ] 앱으로 게인을 바꿔 동작이 달라지는 장면 (튜닝 이해를 보여 줌)

## 9-07 테스트 결과 보고서 템플릿

```
테스트 결과 보고서  BalanceBot v1.0
펌웨어: (git 커밋 해시)    앱: v1.0    HW: Shield v1.0
일시:                     시험자:

| TC | 결과(P/F) | 측정값 | 비고 |
|----|-----------|--------|------|
| TC-01 |  |  |  |
| ...   |  |  |  |

미해결 항목:
조치 계획:
```

`part09_test/test_report_template.md` 에 같은 내용이 있습니다.
