hjunhuh/balancebot-course/(commit log)

2026-11-02 docs: 개요와 목차 작성
2026-11-02 docs: 1. 대상 하드웨어 작성
2026-11-02 docs: 2. 핀맵 (HSI 기준값) 작성
2026-11-02 docs: 3. 주변장치 설정 기준값 작성
2026-11-02 docs: 4. 블루투스 프로토콜 v1 작성
2026-11-02 docs: 5. 기구 기준 치수 작성
2026-11-02 docs: 6. 폴더와 작성 규칙 작성
2026-11-02 chore: .gitignore 설정 추가
2026-11-02 docs: 시작하기 작성
2026-11-02 docs: 폴더 작성
2026-11-02 docs(part01): 개요와 목차 작성
2026-11-02 docs(part01): 1-01 이 과정에서 만드는 것 작성
2026-11-02 docs(part01): 1-02 추천 진행 일정 (6 주) 작성
2026-11-02 docs(part01): 1-03 사전 지식 작성
2026-11-02 docs(part01): 1-04 준비물 작성
2026-11-02 docs(part01): 1-05 저장소 사용법 작성
2026-11-02 docs(part01): 1-06 이 과정의 학습 방식 작성
2026-11-02 docs(part01): 1-07 AI 도구(ChatGPT, Claude 등) 활용 원칙 작성
2026-11-02 docs(part02): 개요와 목차 작성
2026-11-02 docs(part02): 파트 소개: 왜 임베디드에서 C인가 작성
2026-11-02 docs(part02): 개발환경 준비 작성
2026-11-02 docs(part02): 2-01 Hello World와 컴파일 과정 작성
2026-11-02 docs(part02): 2-02 자료형과 고정폭 정수 작성
2026-11-02 docs(part02): 2-03 연산자 작성
2026-11-02 docs(part02): 2-04 비트 연산 작성
2026-11-02 docs(part02): 2-05 조건문 if와 switch 작성
2026-11-02 docs(part02): 2-06 반복문 작성
2026-11-02 docs(part02): 2-07 함수와 스택 작성
2026-11-02 docs(part02): 2-08 배열과 이동평균 필터 작성
2026-11-02 docs(part02): 2-09 문자열과 파싱 작성
2026-11-02 docs(part02): 2-10 포인터 기초 작성
2026-11-02 docs(part02): 2-11 포인터와 배열, 버퍼 처리 작성
2026-11-02 docs(part02): 2-12 구조체 작성
2026-11-02 docs(part02): 2-13 공용체, 엔디언, 비트필드 작성
2026-11-02 docs(part02): 2-14 enum과 상태 머신 작성
2026-11-02 docs(part02): 2-15 전처리기 작성
2026-11-02 docs(part02): 2-16 스코프, static, const, volatile 작성
2026-11-02 docs(part02): 2-17 함수 포인터와 명령 테이블 작성
2026-11-02 docs(part02): 2-18 미니 프로젝트: 링버퍼 (다중 파일) 작성
2026-11-02 docs(part02): Part 3으로 가기 전 체크리스트 작성
2026-11-02 feat(part02): 01_hello.c 추가
2026-11-02 feat(part02): 02_types.c 추가
2026-11-02 feat(part02): 03_operators.c 추가
2026-11-02 feat(part02): 04_bitwise.c 추가
2026-11-02 feat(part02): 05_if_switch.c 추가
2026-11-02 feat(part02): 06_loops.c 추가
2026-11-02 feat(part02): 07_functions.c 추가
2026-11-02 feat(part02): 08_arrays.c 추가
2026-11-02 feat(part02): 09_strings.c 추가
2026-11-02 feat(part02): 10_pointers.c 추가
2026-11-02 feat(part02): 11_pointer_array.c 추가
2026-11-02 feat(part02): 12_struct.c 추가
2026-11-02 feat(part02): 13_union_bitfield.c 추가
2026-11-02 feat(part02): 14_enum_state_machine.c 추가
2026-11-02 feat(part02): 15_preprocessor.c 추가
2026-11-02 feat(part02): 16_volatile_static_const.c 추가
2026-11-02 feat(part02): 17_function_pointer.c 추가
2026-11-02 feat(part02): 18_ringbuffer/main.c 추가
2026-11-02 feat(part02): 18_ringbuffer/ringbuf.c 추가
2026-11-02 feat(part02): 18_ringbuffer/ringbuf.h 추가
2026-11-02 chore(part02): Makefile 설정 추가
2026-11-02 docs(part03): 개요와 목차 작성
2026-11-02 docs(part03): 3-00 MCU와 ATmega328P 개요 작성
2026-11-02 docs(part03): 3-01 개발환경 작성
2026-11-02 docs(part03): 3-02 ChatGPT 활용법 작성
2026-11-02 docs(part03): 실습 공통 사항 작성
2026-11-02 docs(part03): 3-03 lab01 LED 깜박이기 (DDR, PORT, _delay_ms) 작성
2026-11-02 docs(part03): 3-04 lab02 비트 연산으로 LED 패턴, 상태 LED 작성
2026-11-02 docs(part03): 3-05 lab03 버튼 입력, 내부 풀업, 소프트웨어 디바운스 작성
2026-11-02 docs(part03): 3-06 lab04 외부 인터럽트 INT1 (하강 엣지, volatile) 작성
2026-11-02 docs(part03): 3-07 lab05 Timer1 CTC 1 ms 틱, millis(), ATOMIC_BLOCK 작성
2026-11-02 docs(part03): 3-08 lab06 Timer0 Fast PWM 으로 LED 밝기 작성
2026-11-02 docs(part03): 3-09 lab07 L298N 모터 구동 (PWM + 방향핀, 램프, 데드존) 작성
2026-11-02 docs(part03): 3-10 lab08 ADC 로 배터리 전압 측정 작성
2026-11-02 docs(part03): 3-11 lab09 UART 송신과 printf 작성
2026-11-02 docs(part03): 3-12 lab10 UART 수신 인터럽트, 링버퍼, 줄 단위 명령 파서 작성
2026-11-02 docs(part03): 3-13 lab11 TWI(I2C) 드라이버와 MPU6050 작성
2026-11-02 docs(part03): 3-14 lab12 EEPROM 직접 읽기/쓰기, 부팅 횟수 작성
2026-11-02 docs(part03): 3-15 lab13 워치독과 리셋 원인 작성
2026-11-02 docs(part03): 3-16 lab14 HC-05 블루투스 (AT 모드, 데이터 모드 에코) 작성
2026-11-02 docs(part03): 3-17 lab15 협력형 스케줄러와 실행시간 측정 작성
2026-11-02 docs(part03): 3-18 주변장치 요약과 Part 8 에서의 재사용 작성
2026-11-02 chore(part03): Makefile 설정 추가
2026-11-02 feat(part03): lab01_blink/main.c 추가
2026-11-02 build(part03): lab01_blink main.hex 빌드 결과 추가
2026-11-02 feat(part03): lab02_gpio_out/main.c 추가
2026-11-02 build(part03): lab02_gpio_out main.hex 빌드 결과 추가
2026-11-02 feat(part03): lab03_gpio_in/main.c 추가
2026-11-02 build(part03): lab03_gpio_in main.hex 빌드 결과 추가
2026-11-02 feat(part03): lab04_ext_interrupt/main.c 추가
2026-11-02 build(part03): lab04_ext_interrupt main.hex 빌드 결과 추가
2026-11-02 feat(part03): lab05_timer_tick/main.c 추가
2026-11-02 build(part03): lab05_timer_tick main.hex 빌드 결과 추가
2026-11-02 feat(part03): lab06_pwm_led/main.c 추가
2026-11-02 build(part03): lab06_pwm_led main.hex 빌드 결과 추가
2026-11-02 feat(part03): lab07_motor_l298n/main.c 추가
2026-11-02 build(part03): lab07_motor_l298n main.hex 빌드 결과 추가
2026-11-02 feat(part03): lab08_adc/main.c 추가
2026-11-02 build(part03): lab08_adc main.hex 빌드 결과 추가
2026-11-02 feat(part03): lab09_uart_tx/main.c 추가
2026-11-02 build(part03): lab09_uart_tx main.hex 빌드 결과 추가
2026-11-02 feat(part03): lab10_uart_rx_ringbuf/main.c 추가
2026-11-02 build(part03): lab10_uart_rx_ringbuf main.hex 빌드 결과 추가
2026-11-02 feat(part03): lab11_i2c_mpu6050/main.c 추가
2026-11-02 build(part03): lab11_i2c_mpu6050 main.hex 빌드 결과 추가
2026-11-02 feat(part03): lab12_eeprom/main.c 추가
2026-11-02 build(part03): lab12_eeprom main.hex 빌드 결과 추가
2026-11-02 feat(part03): lab13_watchdog/main.c 추가
2026-11-02 build(part03): lab13_watchdog main.hex 빌드 결과 추가
2026-11-02 feat(part03): lab14_hc05/main.c 추가
2026-11-02 build(part03): lab14_hc05 main.hex 빌드 결과 추가
2026-11-02 feat(part03): lab15_scheduler/main.c 추가
2026-11-02 build(part03): lab15_scheduler main.hex 빌드 결과 추가
2026-11-02 docs(part04): 개요와 목차 작성
2026-11-02 docs(part04): 4-01 밸런싱 로봇의 원리 작성
2026-11-02 docs(part04): 4-02 부품과 역할 작성
2026-11-02 docs(part04): 4-03 V 모델 작성
2026-11-02 docs(part04): 4-04 개인 프로젝트용 간소화 프로세스 작성
2026-11-02 docs(part04): 4-05 고객 요구사항 (CR) 작성
2026-11-02 docs(part04): 4-06 시스템 요구사항 (SYS) 과 SW 요구사항 (SWR) 작성
2026-11-02 docs(part04): 4-07 HSI 설계서 (Hardware Software Interface) 작성
2026-11-02 docs(part04): 4-08 SW 아키텍처 설계 작성
2026-11-02 docs(part04): 4-09 SW 인터페이스 명세 (주요 함수) 작성
2026-11-02 docs(part04): 4-10 형상 관리: Git, GitLab, Fork 작성
2026-11-02 docs(part04): 4-11 추적성 매트릭스 작성
2026-11-02 docs(part04): HSI.csv 표 추가
    [HSI.csv]
2026-11-02 docs(part04): traceability.csv 표 추가
    [traceability.csv]
2026-11-02 docs(part05): 개요와 목차 작성
2026-11-02 docs(part05): 5-01 전자부품 실무 기초 작성
2026-11-02 docs(part05): 5-02 KiCad 9 설치와 화면 구성 작성
2026-11-02 docs(part05): 5-03 KiCad 빠르게 익히기: LED 회로 작성
2026-11-02 docs(part05): 5-04 PCB 설계 기본 원칙 작성
2026-11-02 docs(part05): 5-05 밸런싱로봇 쉴드 회로도 작성
2026-11-02 docs(part05): 5-06 부품 선정과 풋프린트 (BOM) 작성
2026-11-02 docs(part05): 5-07 배치와 배선 작성
2026-11-02 docs(part05): 5-08 DRC 와 3D 확인 작성
2026-11-02 docs(part05): 5-09 거버 생성과 발주 작성
2026-11-02 docs(part05): 5-10 납땜과 전원 투입 전 점검 작성
2026-11-02 docs(part05): 5-11 PCB 가 오기 전에: 만능기판 또는 브레드보드 작성
2026-11-02 docs(part05): 5-12 연습 문제 작성
2026-11-02 docs(part05): BOM.csv 표 추가
    [BOM.csv]
2026-11-02 docs(part05): shield_block.svg 그림 추가
2026-11-02 docs(part06): 개요와 목차 작성
2026-11-02 docs(part06): 6-01 기구 설계가 제어에 미치는 영향 작성
2026-11-02 docs(part06): 6-02 Fusion360 설치(개인용 무료 라이선스)와 화면 구성, 단위 mm 설정 작성
2026-11-02 docs(part06): 6-03 스케치 기본 (선, 사각형, 원, 구속조건, 치수 구속, 완전 구속 확인) 작성
2026-11-02 docs(part06): 6-04 Extrude, Hole, Fillet, Chamfer, Mirror, Pattern 작성
2026-11-02 docs(part06): 6-05 하판 모델링 따라하기 (단계별 클릭 순서와 수치) 작성
2026-11-02 docs(part06): 6-06 중판 작성
2026-11-02 docs(part06): 6-07 상판 작성
2026-11-02 docs(part06): 6-08 모터 브래킷 작성
2026-11-02 docs(part06): 6-09 배터리팩, DC 모터, 바퀴 단순 모델 (조립 확인용) 작성
2026-11-02 docs(part06): 6-10 2D 도면 작성 (Drawing 워크스페이스) 작성
2026-11-02 docs(part06): 6-11 어셈블리와 Joint (Rigid, Revolute), 간섭 검사(Interference) 작성
2026-11-02 docs(part06): 6-12 STL 내보내기와 3D 프린팅 작성
2026-11-02 docs(part06): 6-13 조립 순서 작성
2026-11-02 docs(part06): 6-14 제공 STL과 생성 스크립트 사용법 (치수 바꾸고 다시 생성) 작성
2026-11-02 feat(part06): cad/generate.py 추가
2026-11-02 feat(part06): plate_bottom.dxf 모델 출력
    [plate_bottom.dxf]
2026-11-02 feat(part06): plate_middle.dxf 모델 출력
    [plate_middle.dxf]
2026-11-02 feat(part06): plate_top.dxf 모델 출력
    [plate_top.dxf]
2026-11-02 docs(part06): assembly_preview.png 그림 추가
2026-11-02 docs(part06): drawing_bottom.png 그림 추가
2026-11-02 docs(part06): drawing_bracket.png 그림 추가
2026-11-02 docs(part06): drawing_middle.png 그림 추가
2026-11-02 docs(part06): drawing_top.png 그림 추가
2026-11-02 feat(part06): motor_bracket.stl 모델 출력
    [motor_bracket.stl]
2026-11-02 feat(part06): plate_bottom.stl 모델 출력
    [plate_bottom.stl]
2026-11-02 feat(part06): plate_middle.stl 모델 출력
    [plate_middle.stl]
2026-11-02 feat(part06): plate_top.stl 모델 출력
    [plate_top.stl]
2026-11-02 docs(part07): 개요와 목차 작성
2026-11-02 docs(part07): 7-01 앱이 하는 일과 화면 설계 작성
2026-11-02 docs(part07): 7-02 Android Studio 설치와 새 프로젝트 만들기 작성
2026-11-02 docs(part07): 7-03 Android 프로젝트 구조 작성
2026-11-02 docs(part07): 7-04 ChatGPT로 레이아웃 설계하기 작성
2026-11-02 docs(part07): 7-05 레이아웃 XML 작성
2026-11-02 docs(part07): 7-06 블루투스 권한과 페어링 작성
2026-11-02 docs(part07): 7-07 BluetoothService (연결, 송신, 수신 스레드) 작성
2026-11-02 docs(part07): 7-08 프로토콜 클래스와 체크섬 작성
2026-11-02 docs(part07): 7-09 조이스틱 커스텀 뷰 작성
2026-11-02 docs(part07): 7-10 PID 튜닝 UI 작성
2026-11-02 docs(part07): 7-11 텔레메트리 표시 작성
2026-11-02 docs(part07): 7-12 휴대폰에 설치하고 HC-05 와 테스트하기 작성
2026-11-02 docs(part07): 7-13 문제 해결 체크리스트 (앱 코드 관점) 작성
2026-11-02 chore(part07): app/build.gradle 설정 추가
2026-11-02 feat(part07): app/src/main/AndroidManifest.xml 추가
2026-11-02 feat(part07): app/src/main/java/com/example/balancebot/BluetoothService.java 추가
2026-11-02 feat(part07): app/src/main/java/com/example/balancebot/JoystickView.java 추가
2026-11-02 feat(part07): app/src/main/java/com/example/balancebot/MainActivity.java 추가
2026-11-02 feat(part07): app/src/main/java/com/example/balancebot/Protocol.java 추가
2026-11-02 feat(part07): app/src/main/res/layout/activity_main.xml 추가
2026-11-02 feat(part07): app/src/main/res/values/strings.xml 추가
2026-11-02 feat(part07): app/src/main/res/values/themes.xml 추가
2026-11-02 chore(part07): build.gradle 설정 추가
2026-11-02 chore(part07): gradle.properties 설정 추가
2026-11-02 chore(part07): gradle/wrapper/gradle-wrapper.properties 설정 추가
2026-11-02 chore(part07): settings.gradle 설정 추가
2026-11-02 test(part07): ProtocolTest.java 테스트 추가
2026-11-02 docs(part08): 개요와 목차 작성
2026-11-02 docs(part08): 8-01 SW 구조 한눈에 보기 작성
2026-11-02 docs(part08): 8-02 Microchip Studio 프로젝트 만들기 작성
2026-11-02 docs(part08): 8-03 설정 파일: config.h 작성
2026-11-02 docs(part08): 8-04 BSW: 시스템 틱 (Timer1) 작성
2026-11-02 docs(part08): 8-05 BSW: GPIO 와 PWM 작성
2026-11-02 docs(part08): 8-06 BSW: UART 링버퍼 작성
2026-11-02 docs(part08): 8-07 BSW: I2C (TWI) 와 타임아웃 작성
2026-11-02 docs(part08): 8-08 BSW: ADC 와 EEPROM 작성
2026-11-02 docs(part08): 8-09 드라이버: MPU6050 작성
2026-11-02 docs(part08): 8-10 드라이버: 모터와 데드존 작성
2026-11-02 docs(part08): 8-11 칼만 필터 작성
2026-11-02 docs(part08): 8-12 PID 제어 작성
2026-11-02 docs(part08): 8-13 상태 머신과 제어 법칙 작성
2026-11-02 docs(part08): 8-14 시뮬레이터로 먼저 검증하기 (중요) 작성
2026-11-02 docs(part08): 8-15 블루투스 프로토콜 구현 작성
2026-11-02 docs(part08): 8-16 EEPROM 파라미터 저장 작성
2026-11-02 docs(part08): 8-17 main: 협력형 스케줄러 작성
2026-11-02 docs(part08): 8-18 PC 단위 테스트 작성
2026-11-02 docs(part08): 8-19 보드 위 단계별 확인 순서 작성
2026-11-02 docs(part08): 8-20 연습 문제 작성
2026-11-02 chore(part08): Makefile 설정 추가
2026-11-02 build(part08): prebuilt balancebot.hex 빌드 결과 추가
2026-11-02 feat(part08): src/asw/balance.c 추가
2026-11-02 feat(part08): src/asw/balance.h 추가
2026-11-02 feat(part08): src/asw/cmd.c 추가
2026-11-02 feat(part08): src/asw/cmd.h 추가
2026-11-02 feat(part08): src/asw/kalman.c 추가
2026-11-02 feat(part08): src/asw/kalman.h 추가
2026-11-02 feat(part08): src/asw/params.c 추가
2026-11-02 feat(part08): src/asw/params.h 추가
2026-11-02 feat(part08): src/asw/pid.c 추가
2026-11-02 feat(part08): src/asw/pid.h 추가
2026-11-02 feat(part08): src/asw/protocol.c 추가
2026-11-02 feat(part08): src/asw/protocol.h 추가
2026-11-02 feat(part08): src/bsw/bsw_adc.c 추가
2026-11-02 feat(part08): src/bsw/bsw_adc.h 추가
2026-11-02 feat(part08): src/bsw/bsw_eeprom.c 추가
2026-11-02 feat(part08): src/bsw/bsw_eeprom.h 추가
2026-11-02 feat(part08): src/bsw/bsw_gpio.c 추가
2026-11-02 feat(part08): src/bsw/bsw_gpio.h 추가
2026-11-02 feat(part08): src/bsw/bsw_i2c.c 추가
2026-11-02 feat(part08): src/bsw/bsw_i2c.h 추가
2026-11-02 feat(part08): src/bsw/bsw_pwm.c 추가
2026-11-02 feat(part08): src/bsw/bsw_pwm.h 추가
2026-11-02 feat(part08): src/bsw/bsw_tick.c 추가
2026-11-02 feat(part08): src/bsw/bsw_tick.h 추가
2026-11-02 feat(part08): src/bsw/bsw_uart.c 추가
2026-11-02 feat(part08): src/bsw/bsw_uart.h 추가
2026-11-02 feat(part08): src/config.h 추가
2026-11-02 feat(part08): src/drv/battery.c 추가
2026-11-02 feat(part08): src/drv/battery.h 추가
2026-11-02 feat(part08): src/drv/motor.c 추가
2026-11-02 feat(part08): src/drv/motor.h 추가
2026-11-02 feat(part08): src/drv/mpu6050.c 추가
2026-11-02 feat(part08): src/drv/mpu6050.h 추가
2026-11-02 feat(part08): src/main.c 추가
2026-11-02 chore(part08): test/Makefile 설정 추가
2026-11-02 test(part08): RESULT.txt 실행 결과 기록
2026-11-02 test(part08): SWEEP_RESULT.txt 실행 결과 기록
2026-11-02 test(part08): sim_balance.c 테스트 추가
2026-11-02 test(part08): stub_bsw.c 테스트 추가
2026-11-02 test(part08): sweep_kalman.sh 테스트 추가
2026-11-02 test(part08): test_params.c 테스트 추가
2026-11-02 test(part08): test_pid_kalman.c 테스트 추가
2026-11-02 test(part08): test_protocol.c 테스트 추가
2026-11-02 test(part08): test_util.h 테스트 추가
2026-11-02 docs(part09): 개요와 목차 작성
2026-11-02 docs(part09): 9-01 통합 순서 작성
2026-11-02 docs(part09): 9-02 준비물 작성
2026-11-02 docs(part09): 9-03 테스트 케이스 명세 작성
2026-11-02 docs(part09): 9-04 PID 튜닝 절차 (실제 로봇) 작성
2026-11-02 docs(part09): 9-05 증상별 확인 포인트 작성
2026-11-02 docs(part09): 9-06 시연 영상 체크리스트 작성
2026-11-02 docs(part09): 9-07 테스트 결과 보고서 템플릿 작성
2026-11-02 test(part09): test_report_template.md 테스트 추가
2026-11-02 docs(part10): 개요와 목차 작성
2026-11-02 docs(part10): 10-01 포트폴리오 구성 작성
2026-11-02 docs(part10): 10-02 문제 해결 사례 쓰는 법 (STAR) 작성
2026-11-02 docs(part10): 10-03 이력서 문구 예시 작성
2026-11-02 docs(part10): 10-04 면접 예상 질문과 답변 포인트 작성
2026-11-02 docs(part10): 10-05 저장소 정리 체크리스트 작성
2026-11-02 feat(part10): portfolio_template.md 추가
2026-11-02 feat(tools): build_site.py 추가
2026-11-02 feat(tools): site_template.html 추가
2026-11-02 docs(site): 학습 사이트 빌드
2026-11-02 chore: Languages 통계에서 HTML 제외 (.gitattributes)
